123Arp/Electronic_System_Project/docs/images/02b_perfboard_with_mic.jpeg

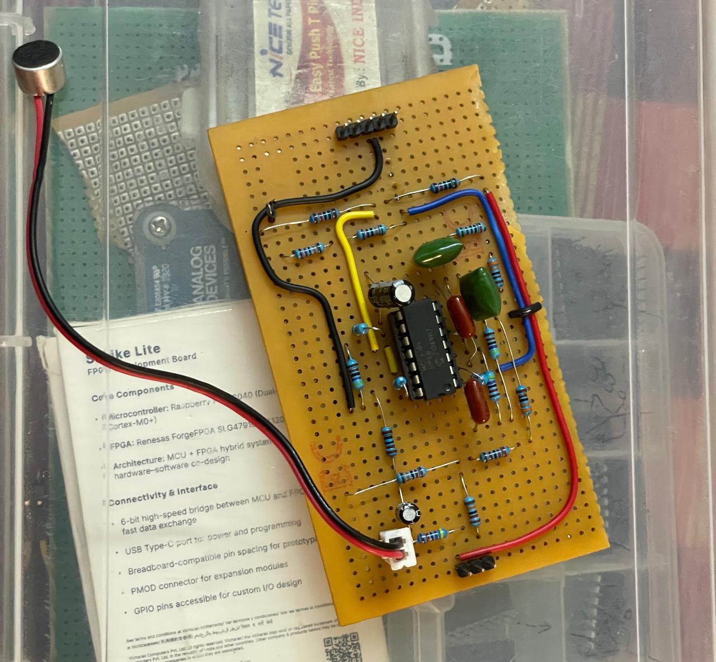
docs/images/02b_perfboard_with_mic.jpeg
