123Arp/Electronic_System_Project/docs/images/raw/WhatsApp Image 2026-10-01 at 6.32.37 PM (9).jpeg

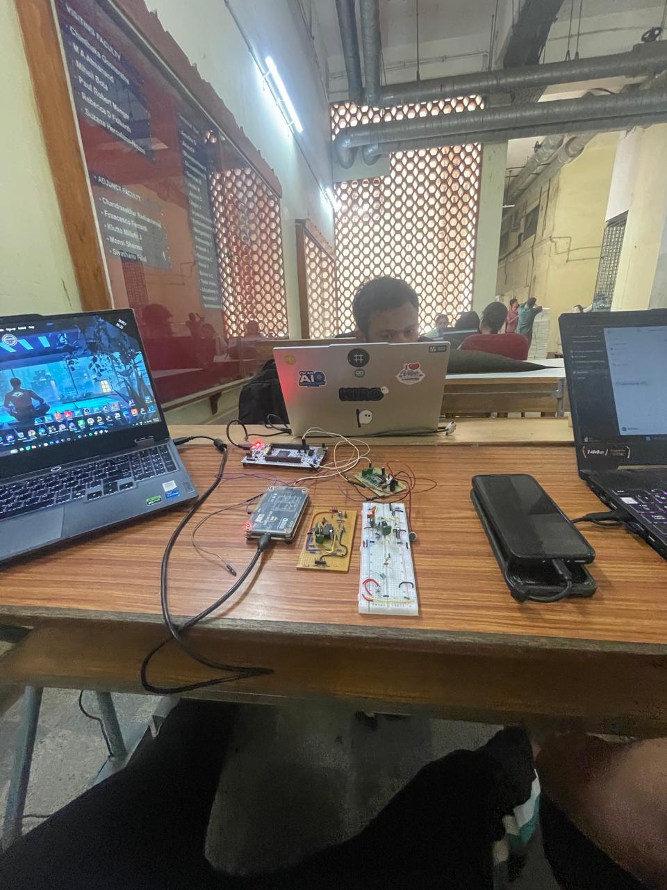
docs/images/raw/WhatsApp Image 2026-10-01 at 6.32.37 PM (9).jpeg
