123Arp/Electronic_System_Project/docs/Project_Report.pdf

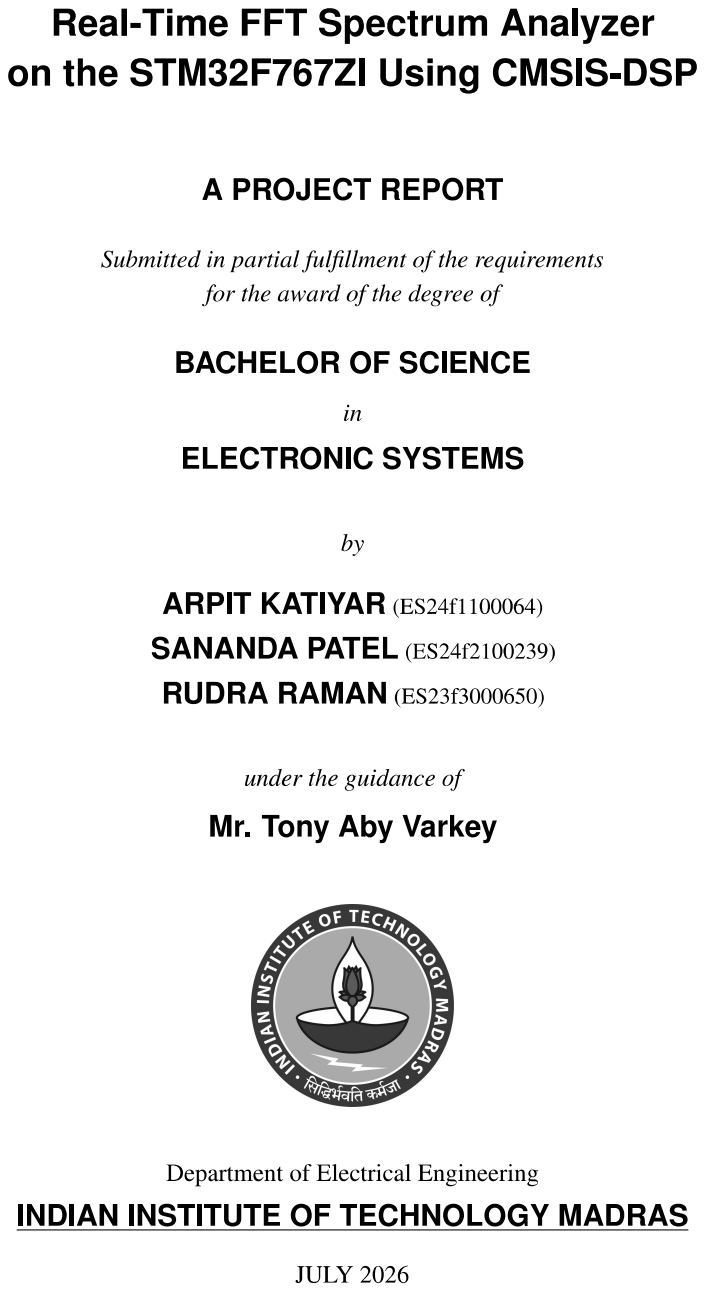
[picture p13: page 1]

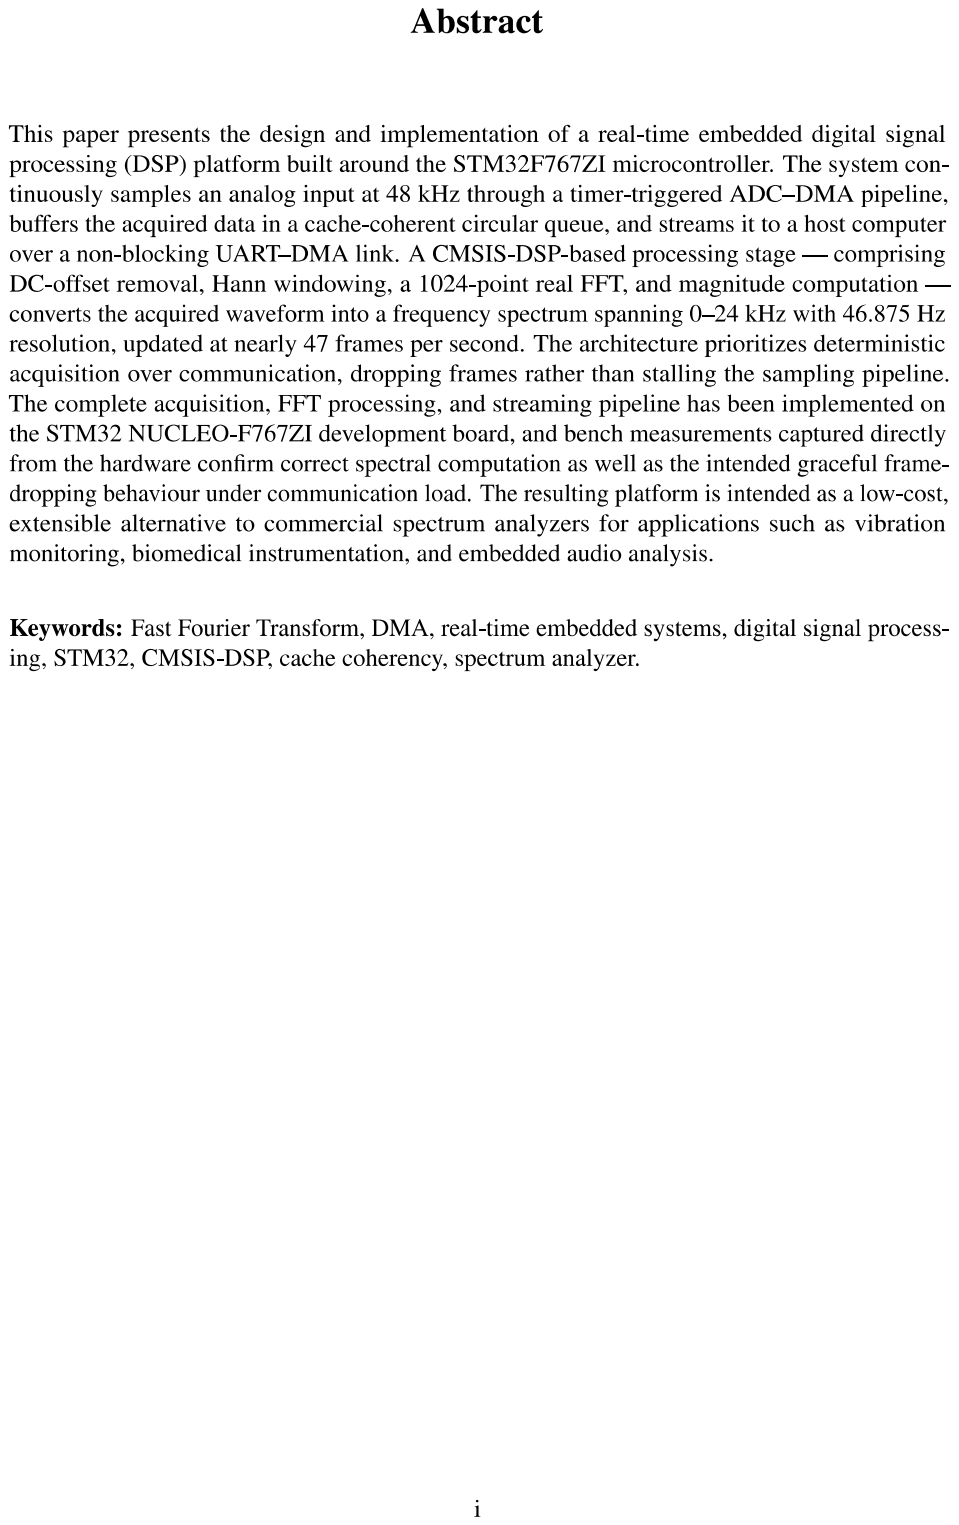
[picture p14: page 2]

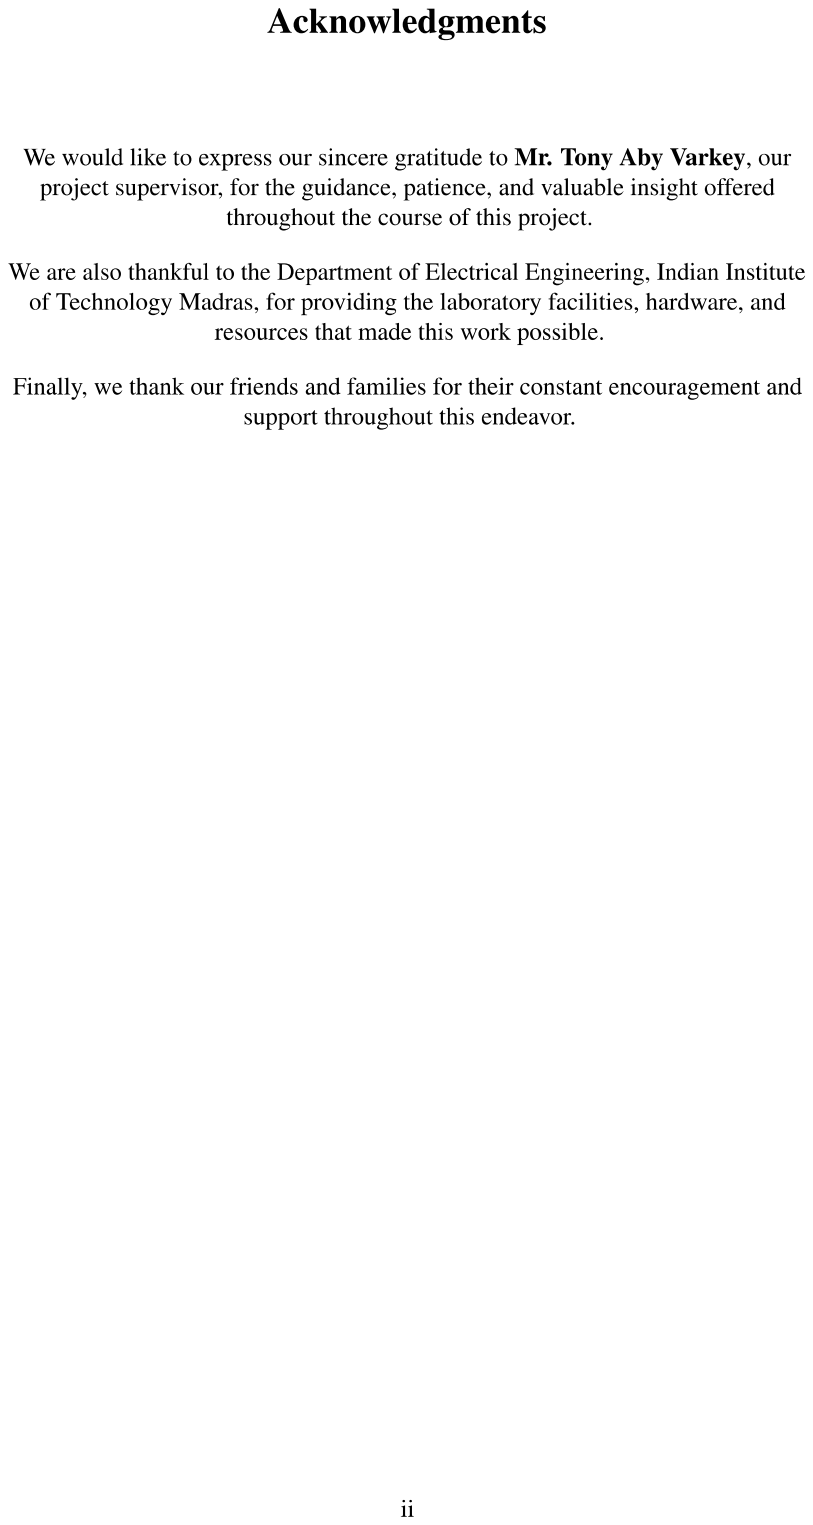
[picture p15: page 3]

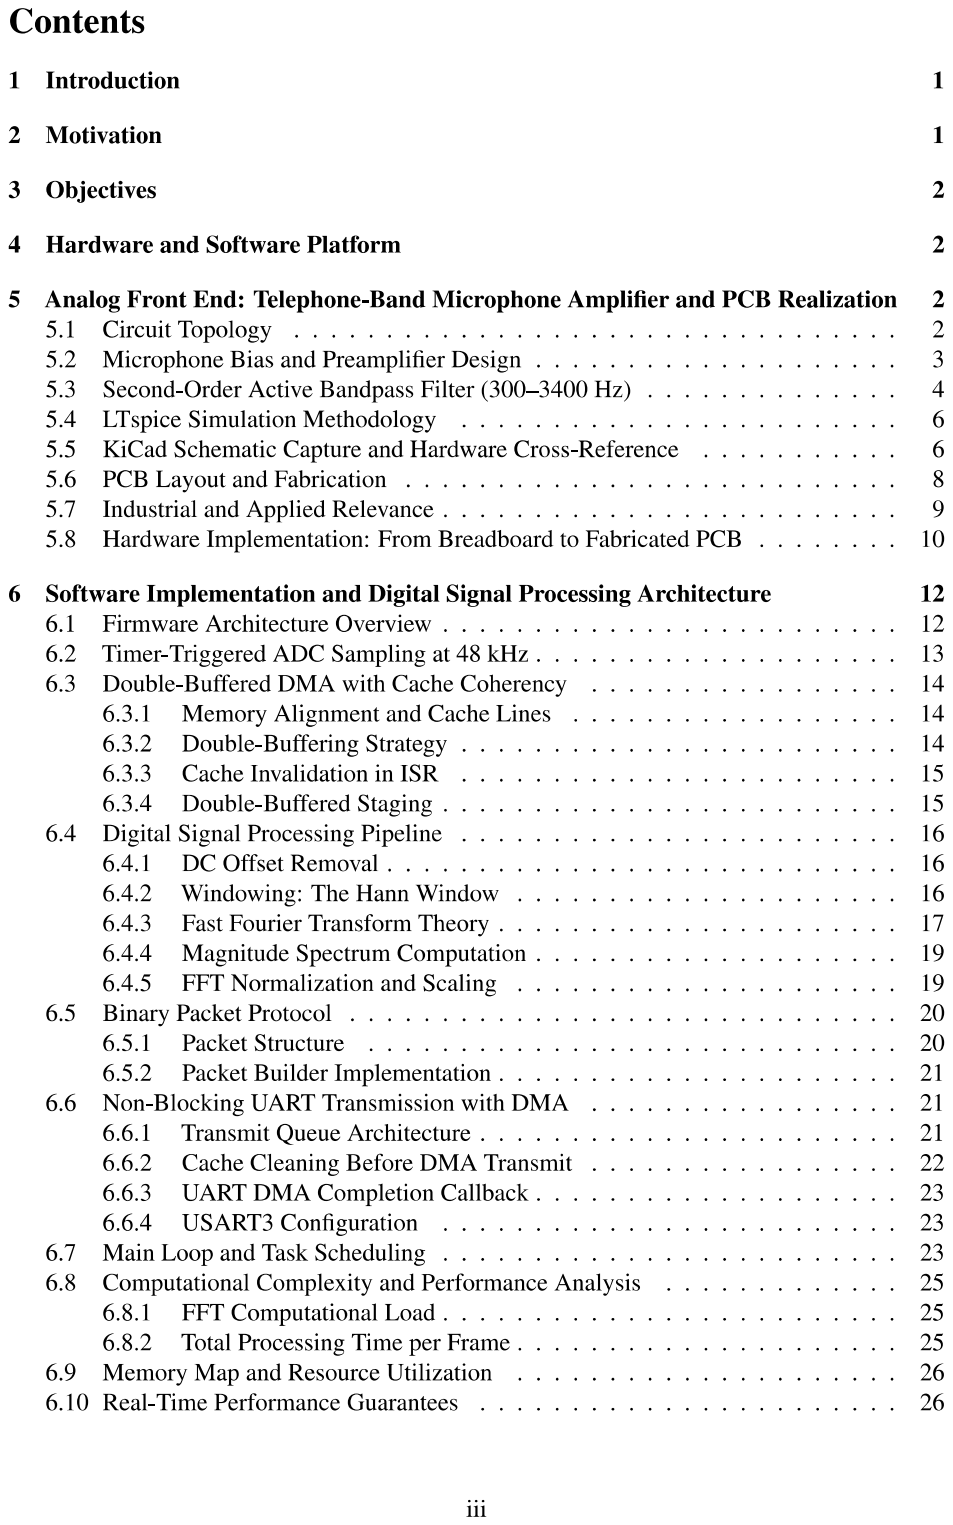
[picture p16: page 4]

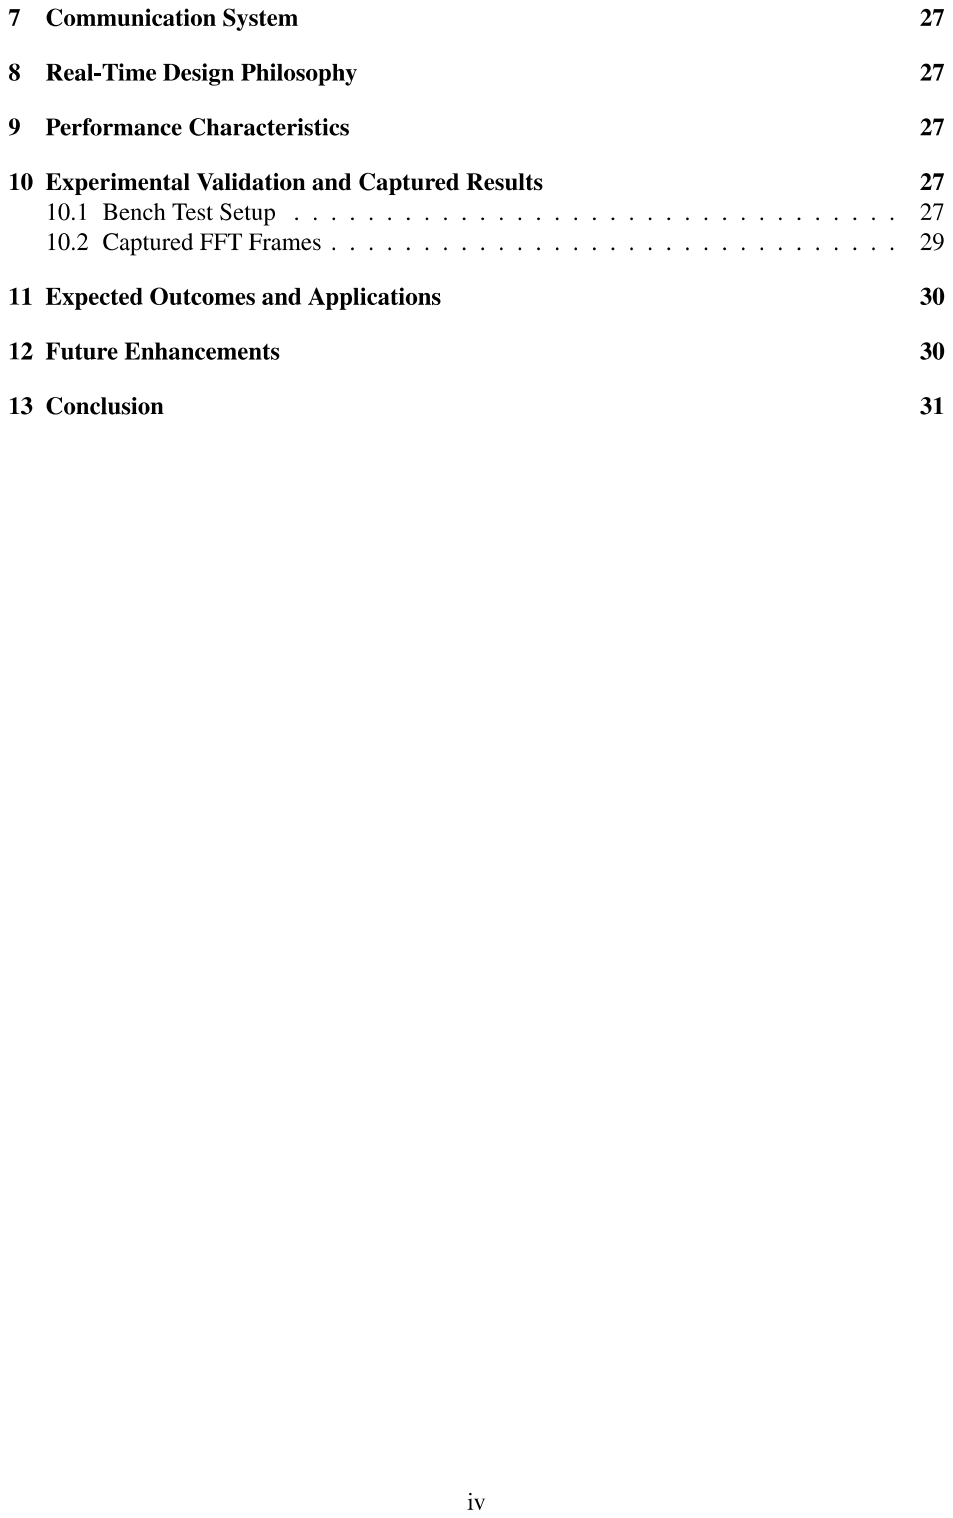
[picture p17: page 5]

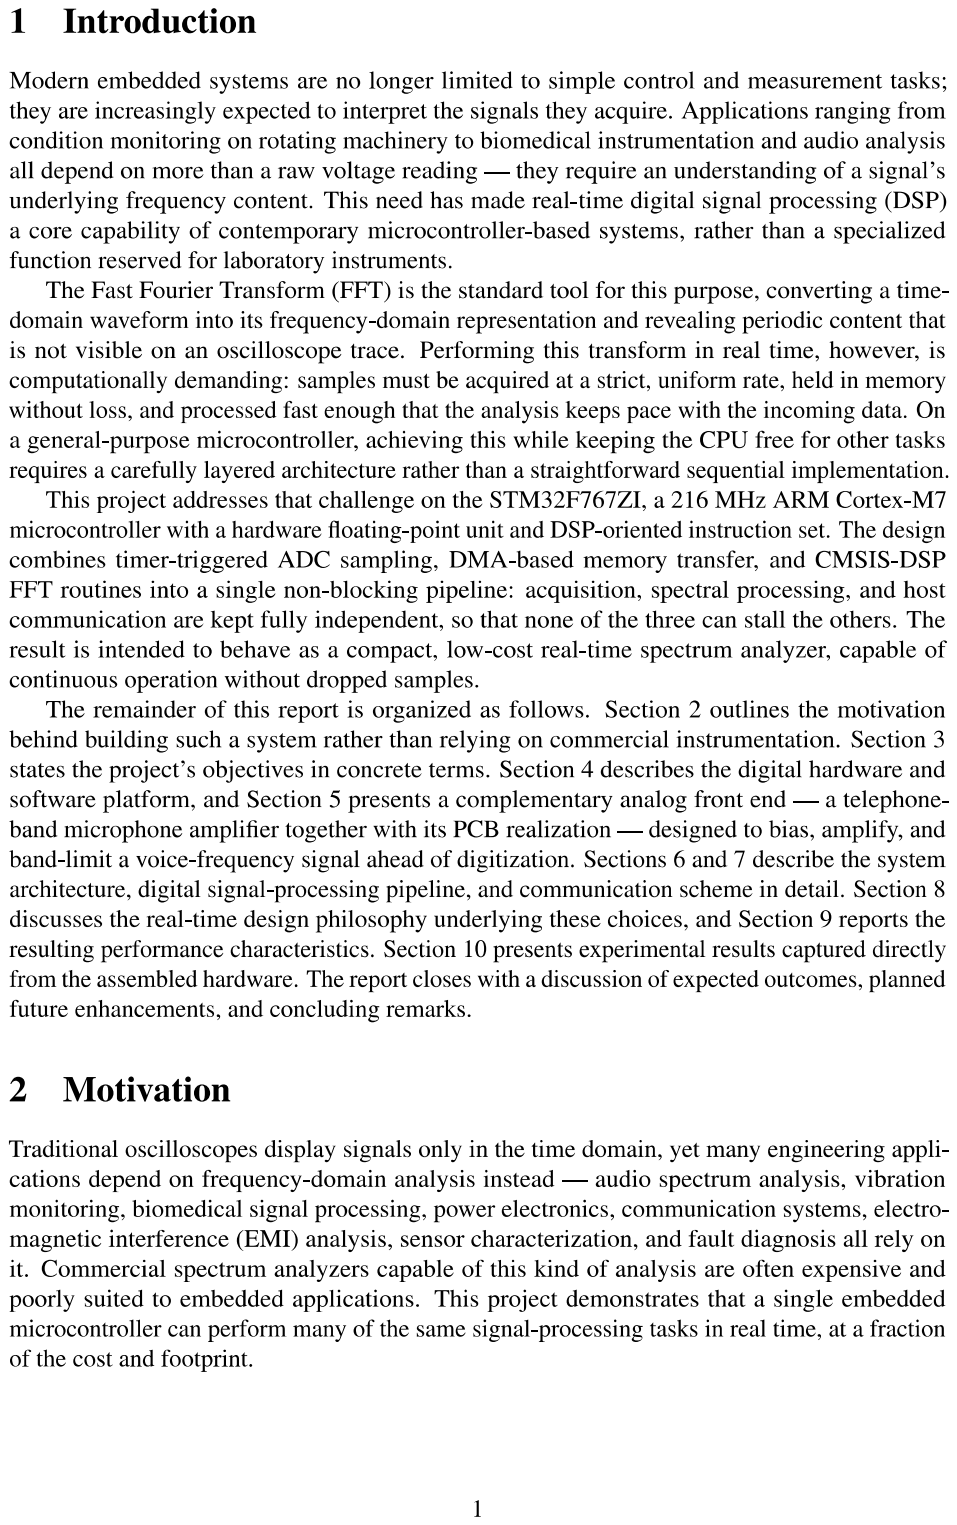
[picture p18: page 6]

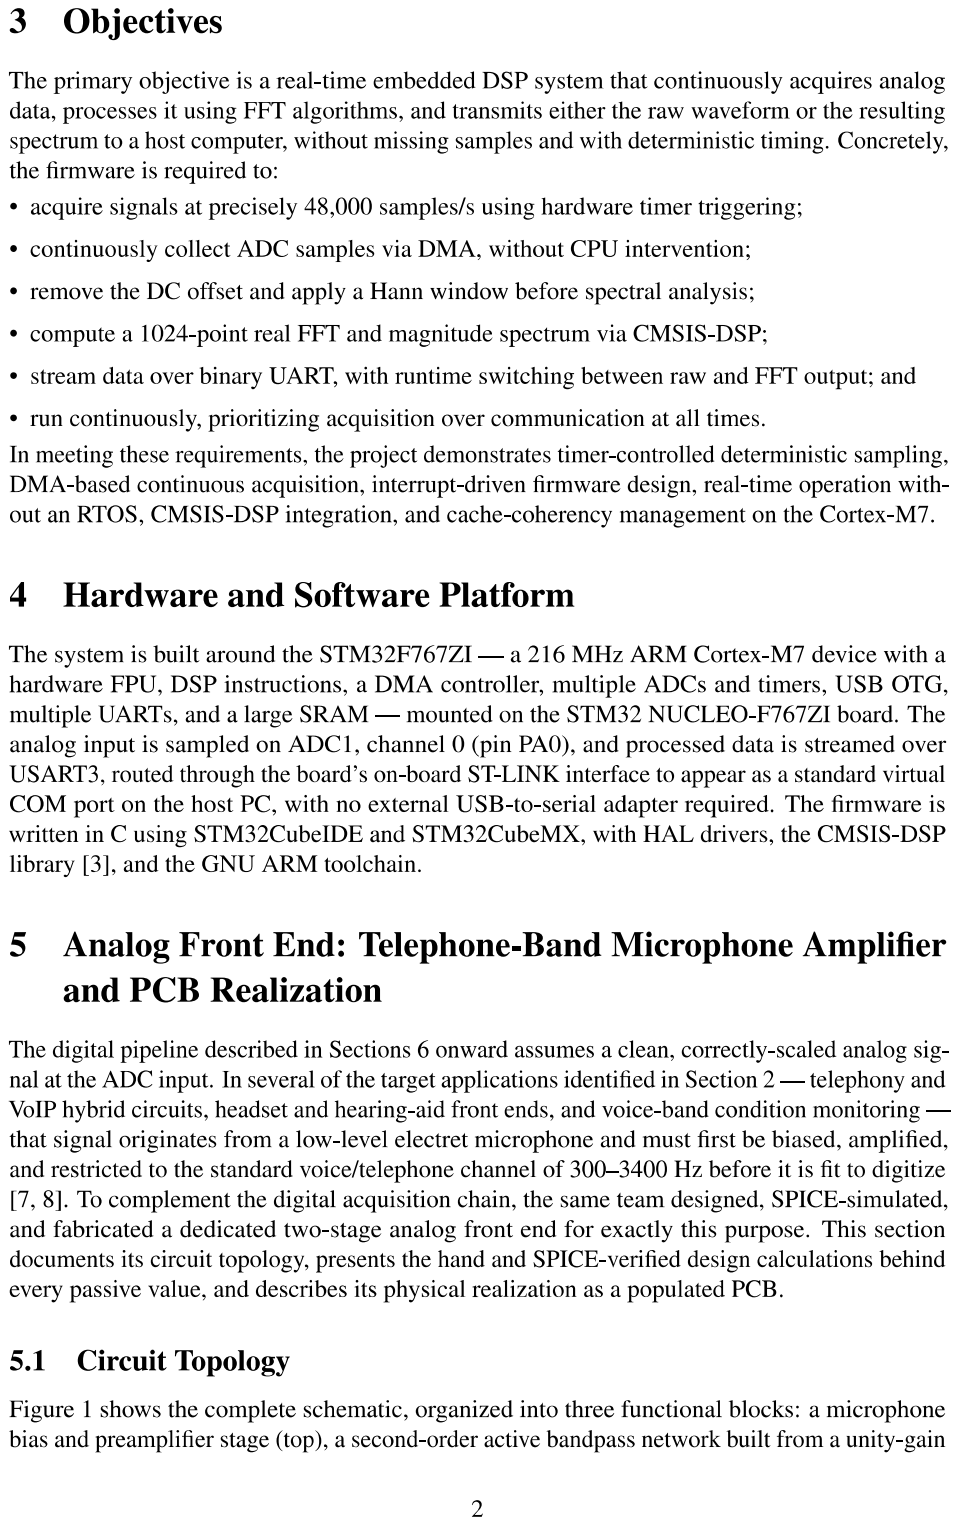
[picture p19: page 7]

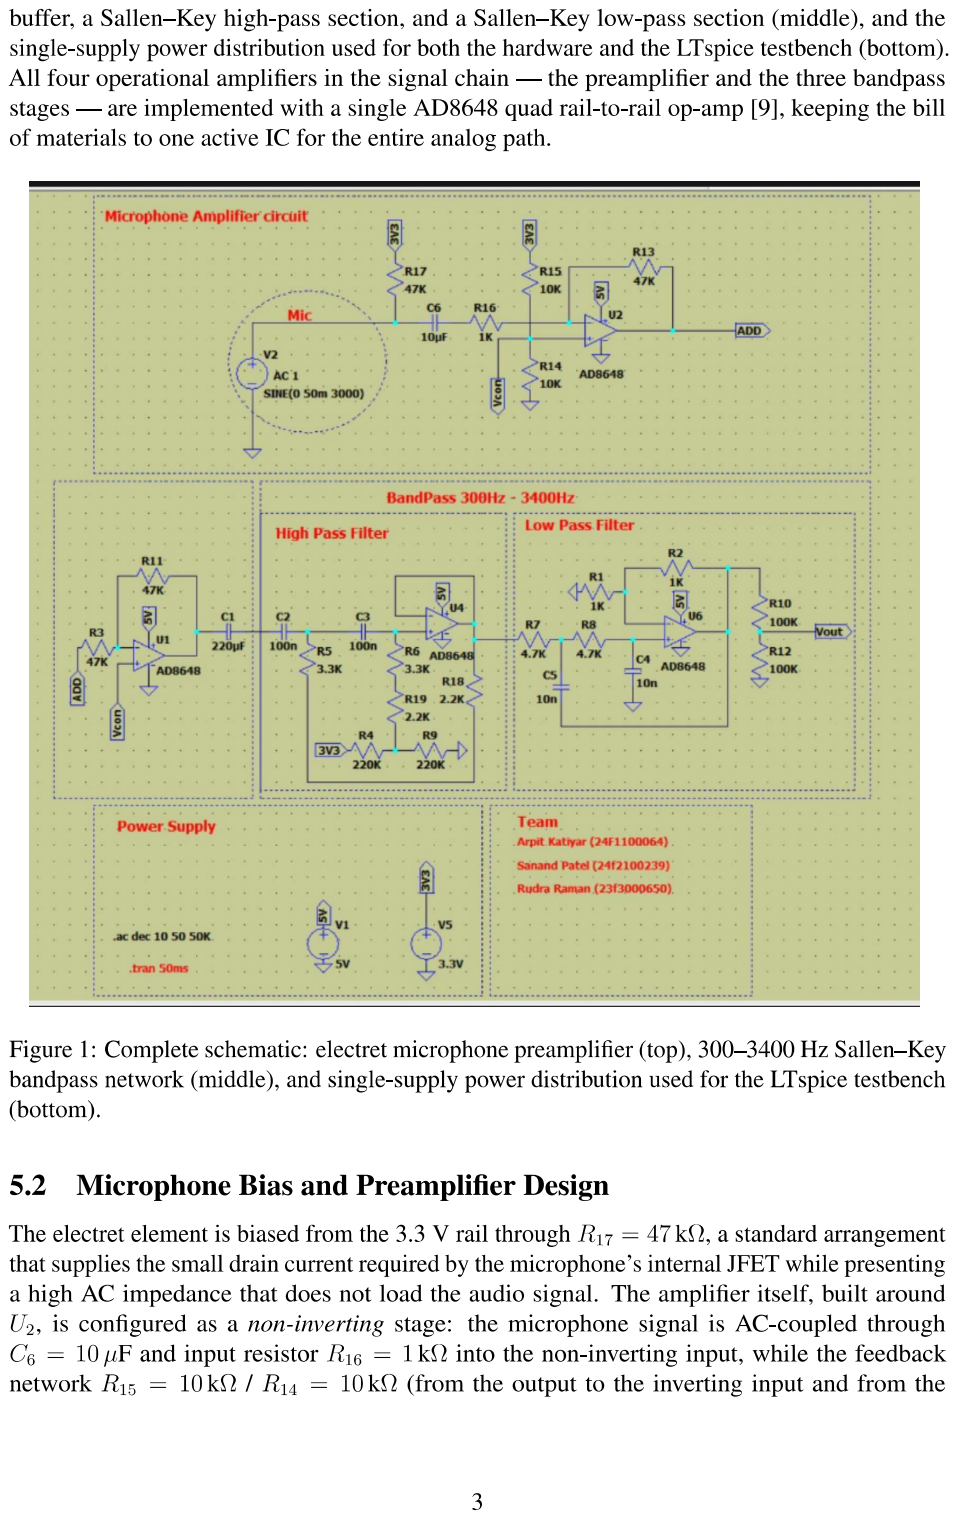
[picture p20: page 8]

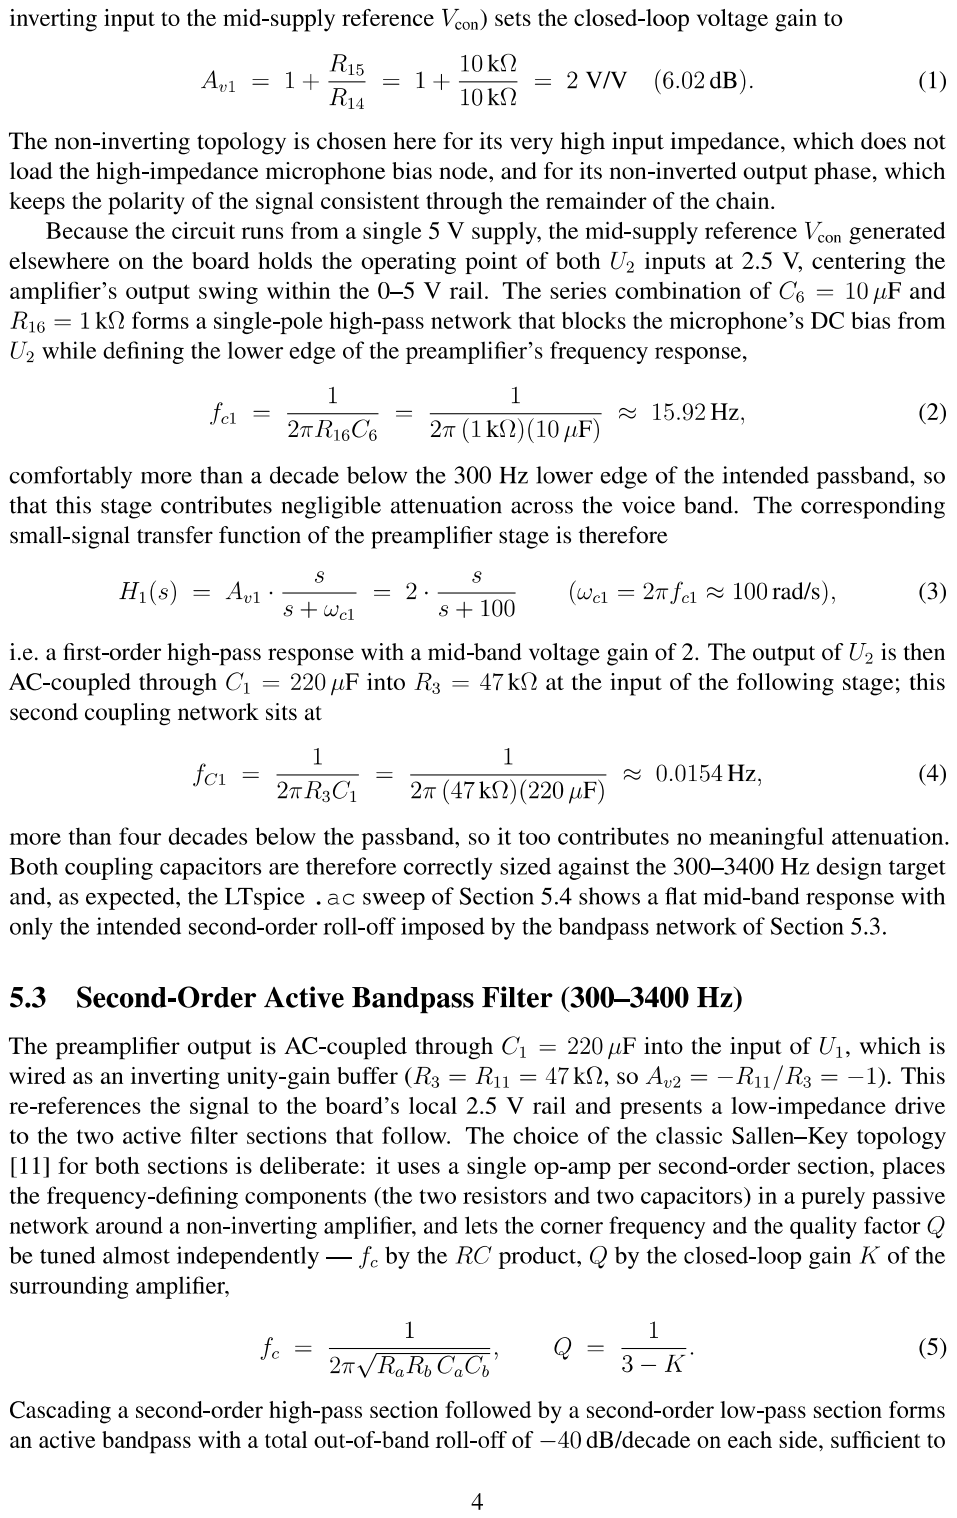
[picture p21: page 9]

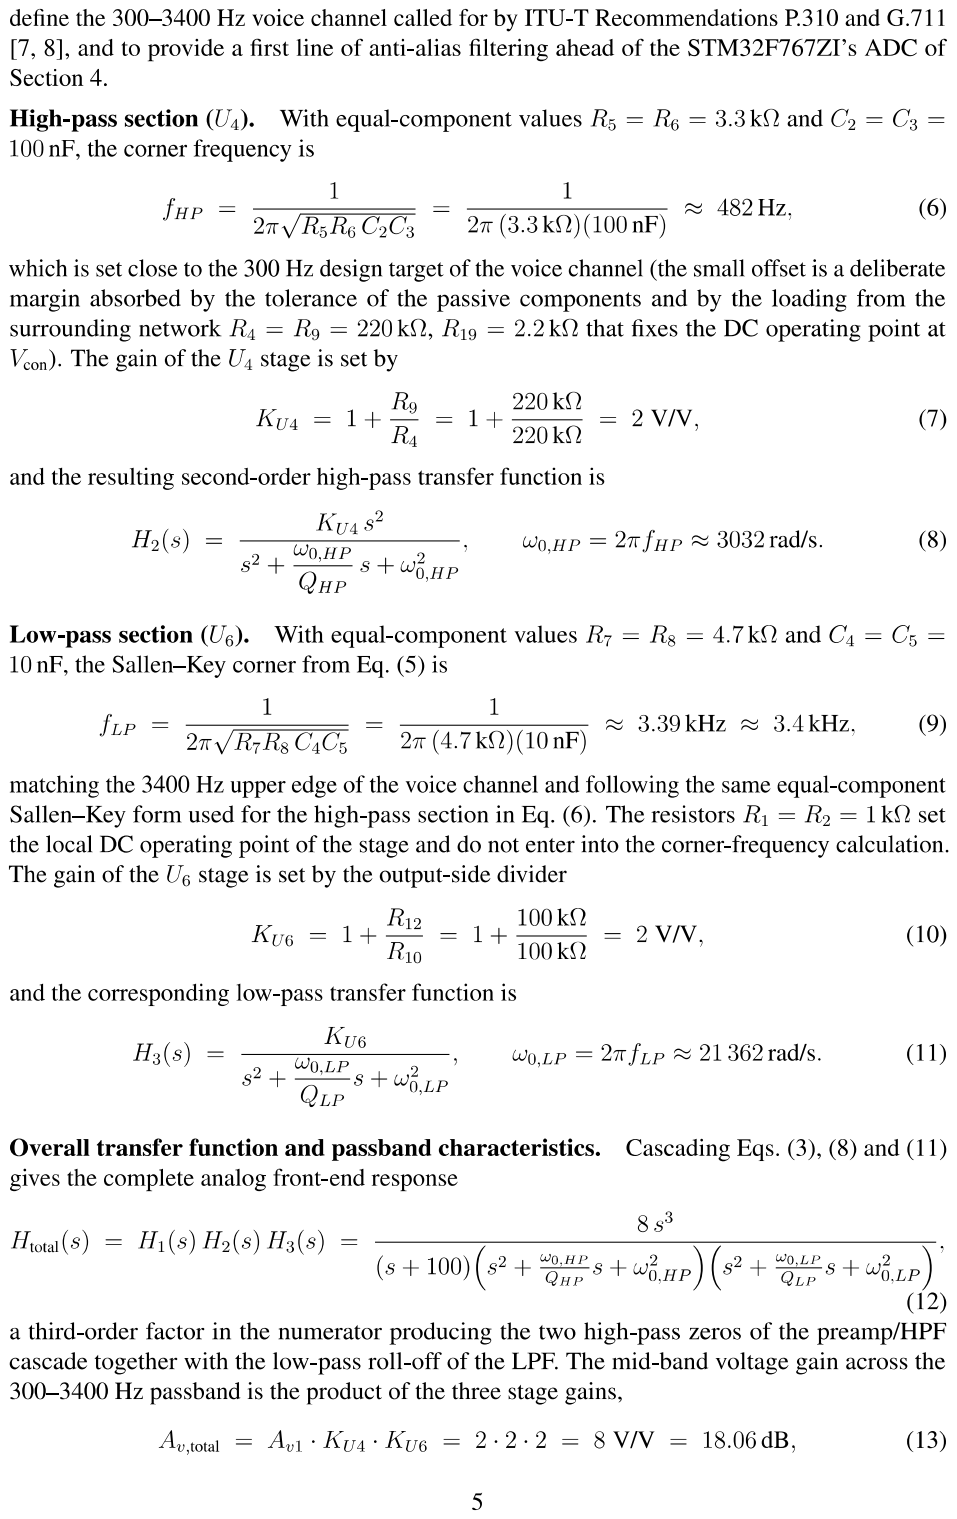
[picture p22: page 10]

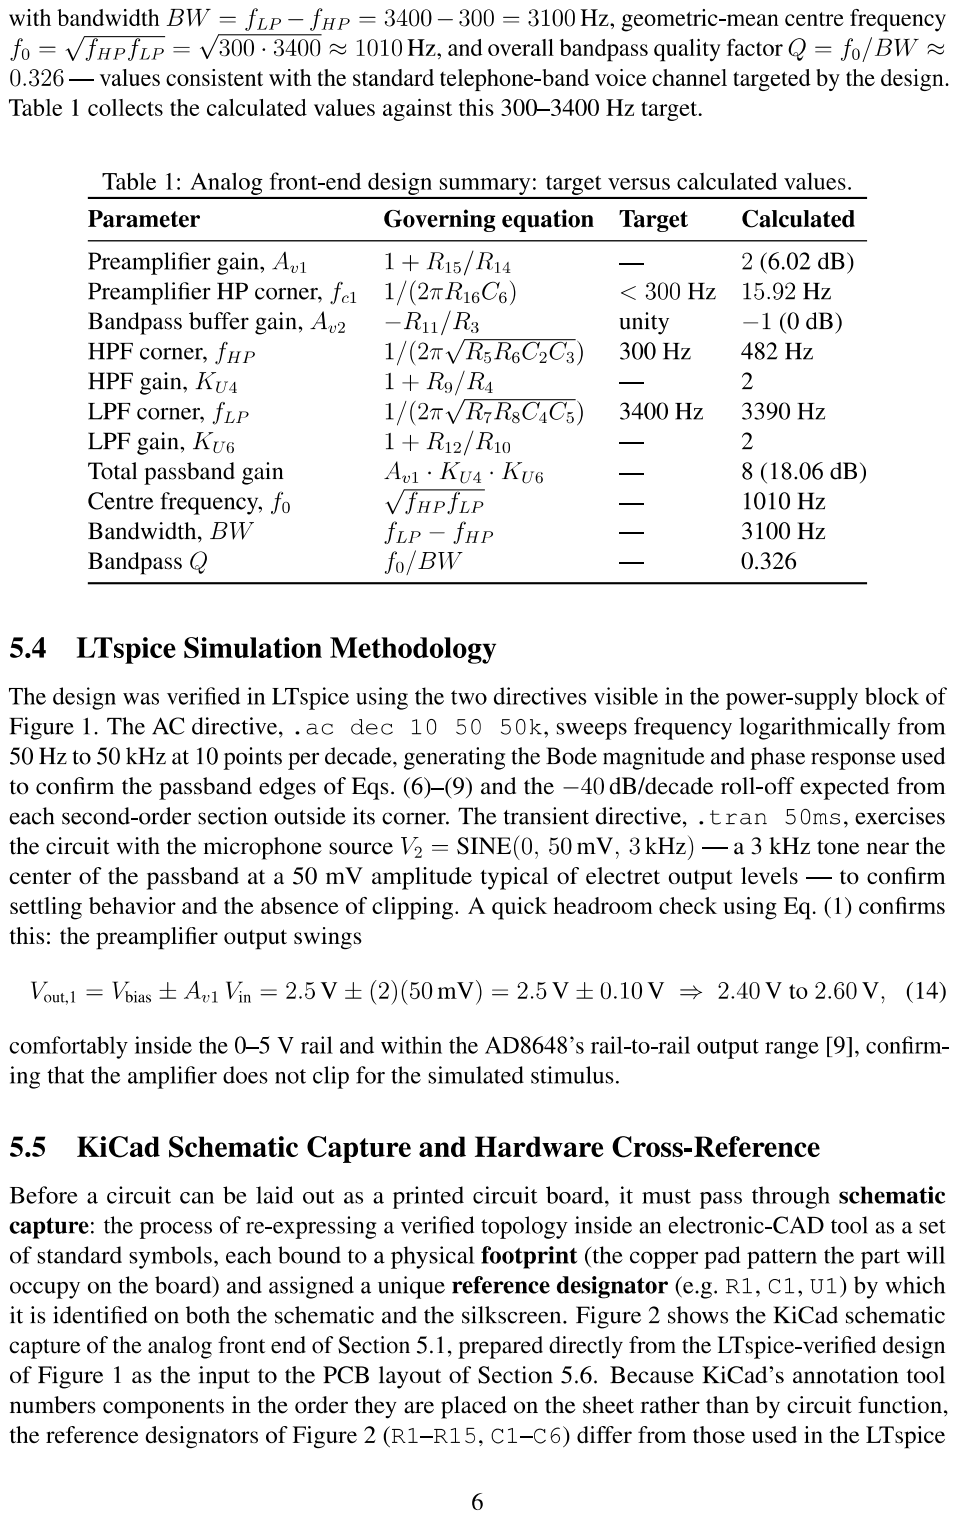
[picture p23: page 11]

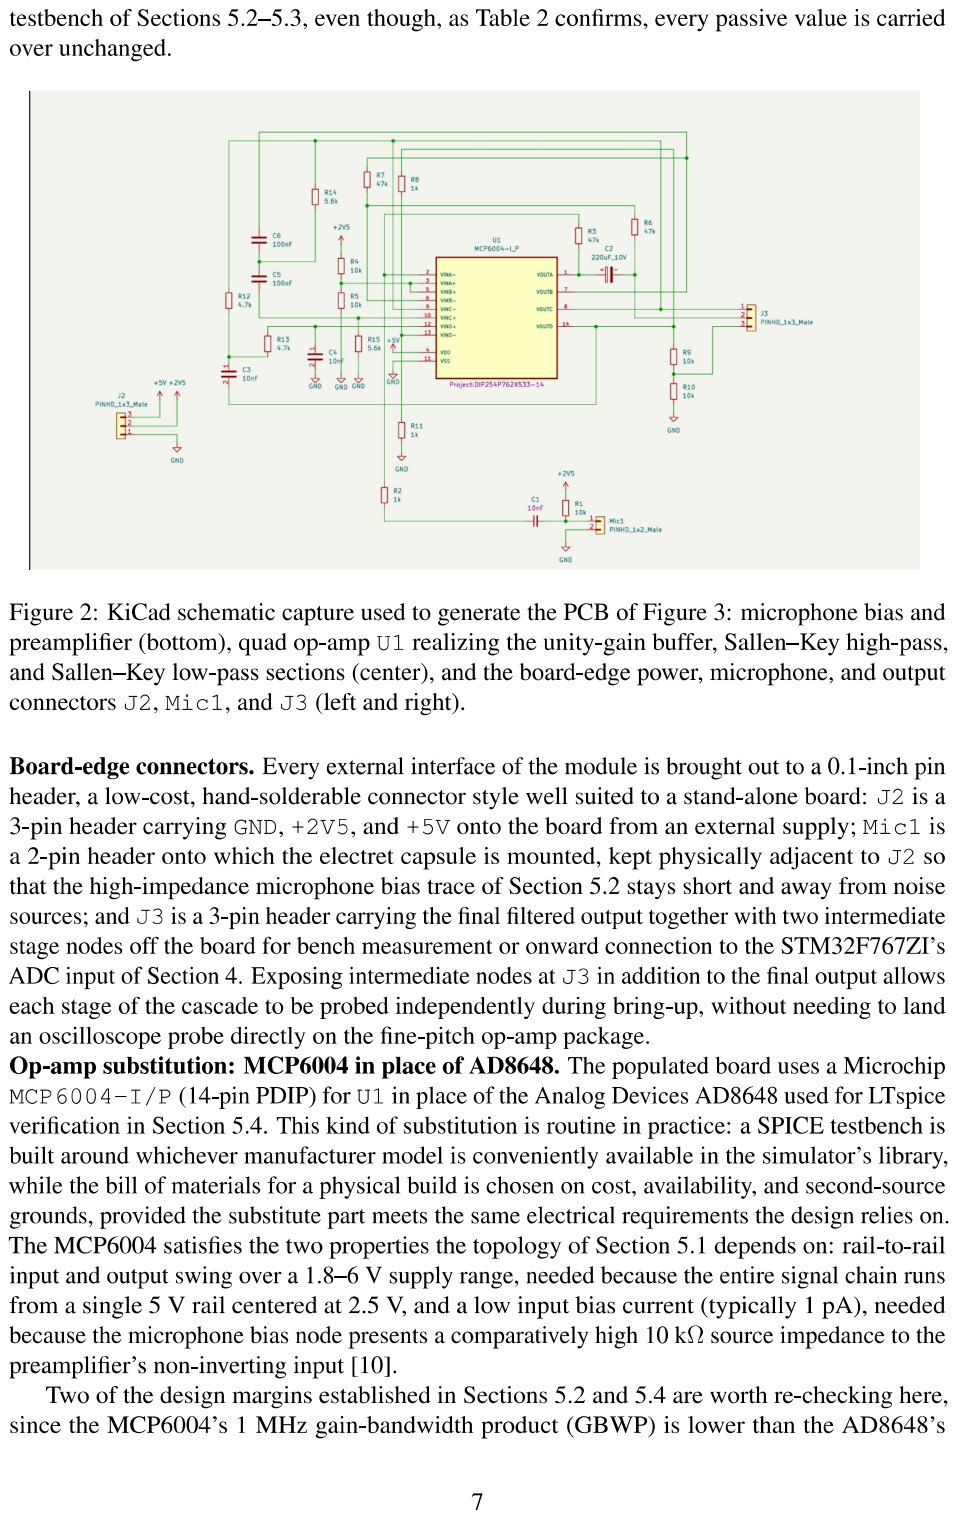
[picture p24: page 12]

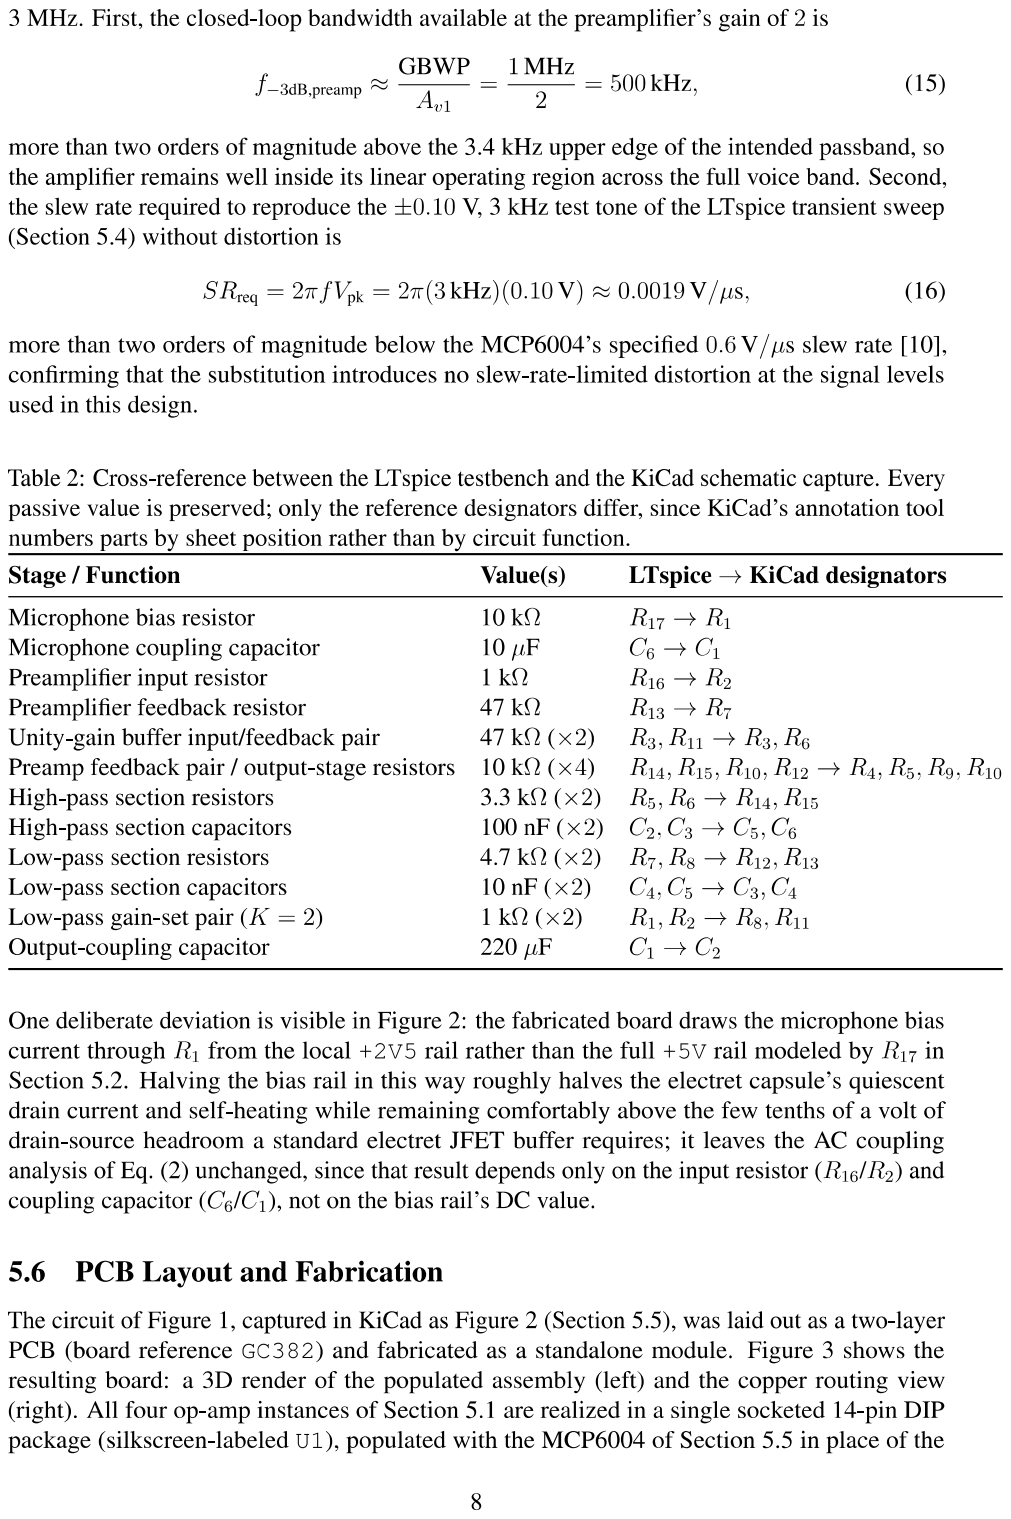
[picture p25: page 13]

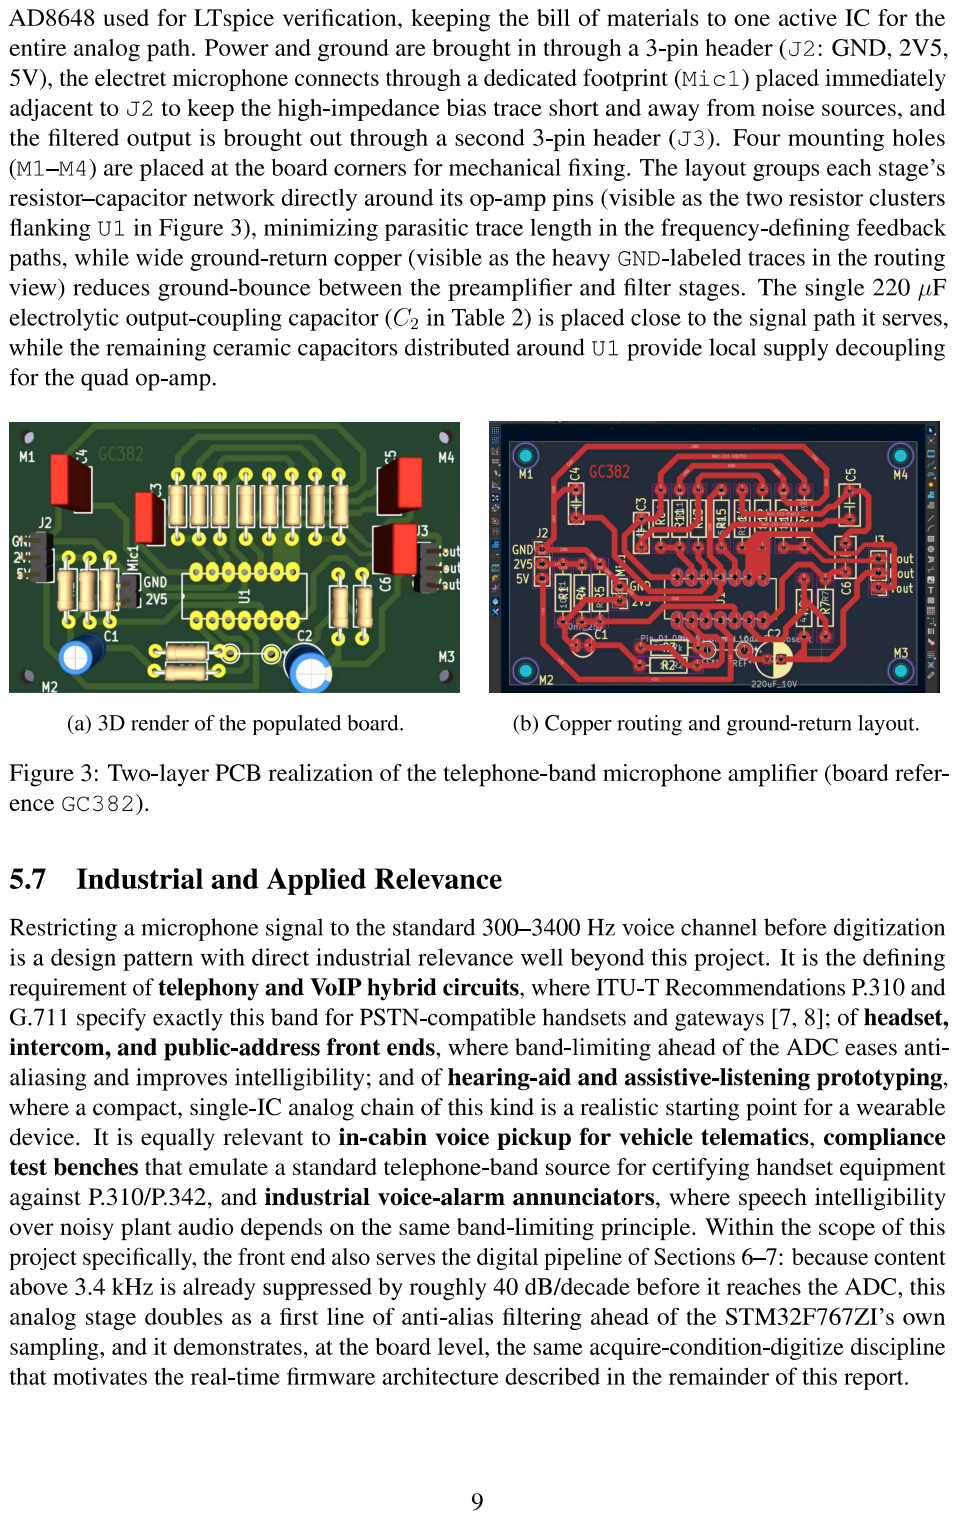
[picture p26: page 14]

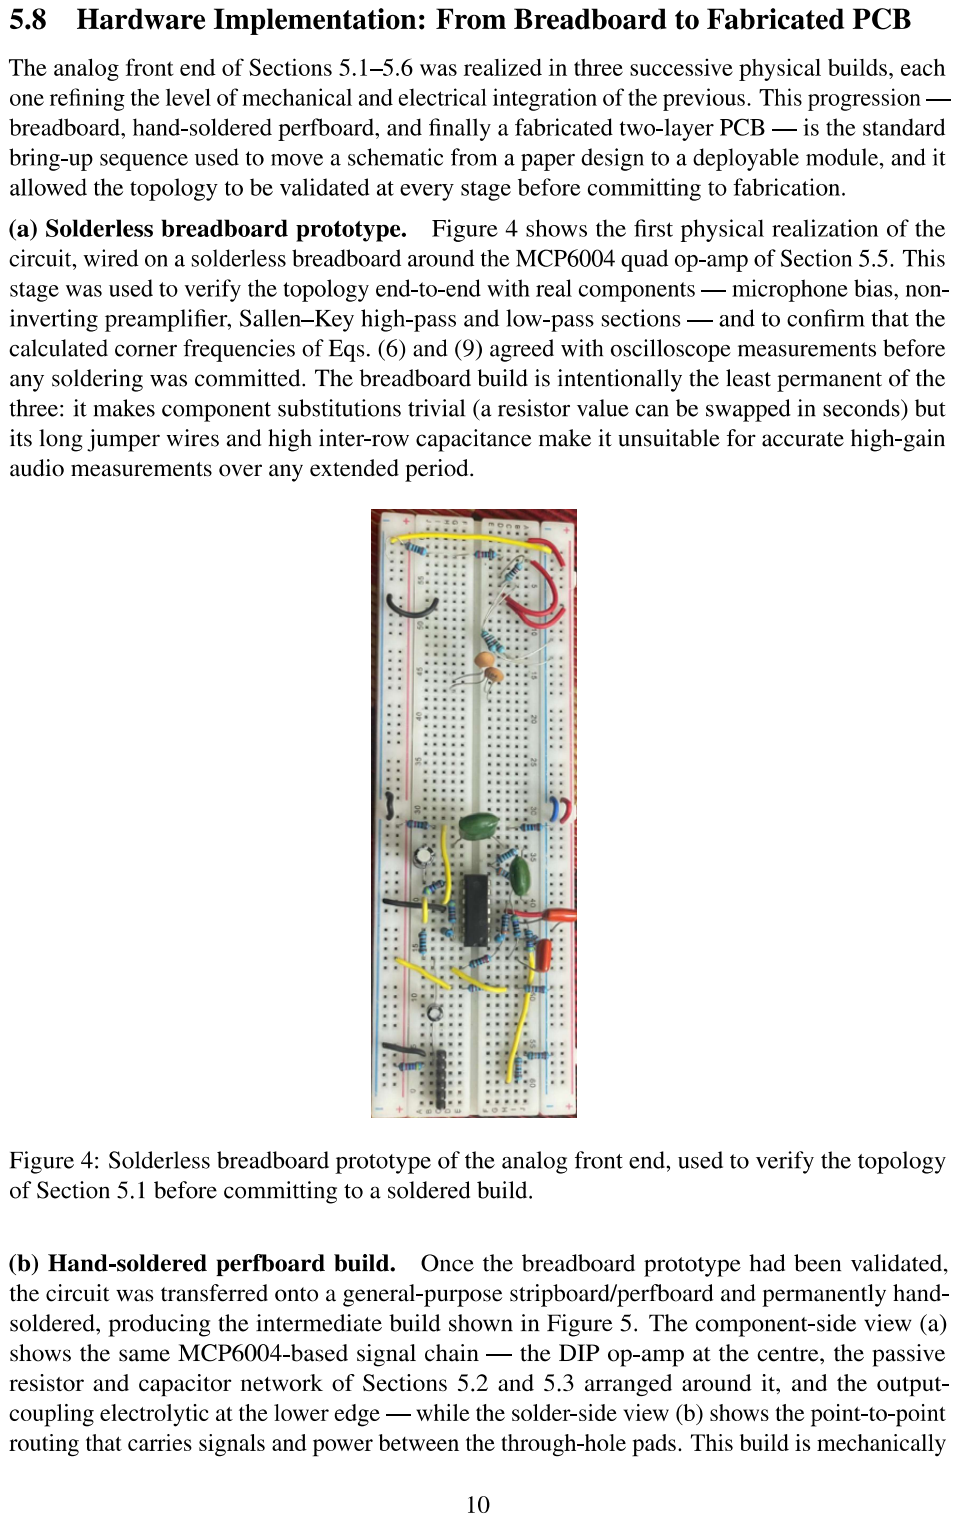
[picture p27: page 15]

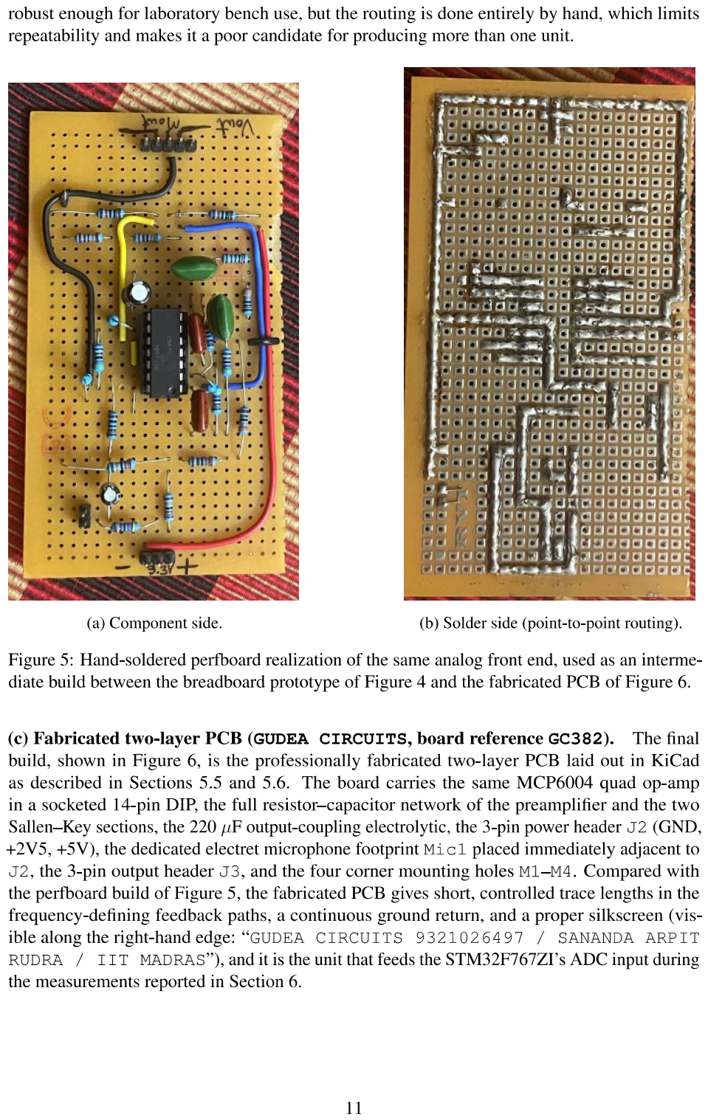
[picture p28: page 16]

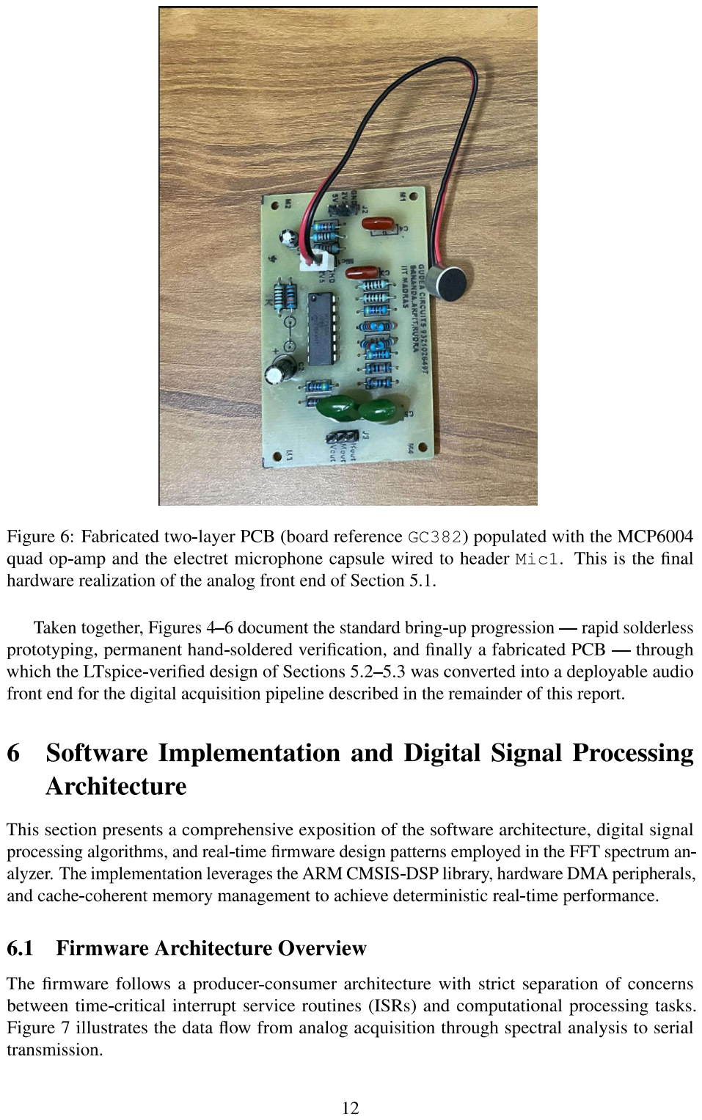
[picture p29: page 17]

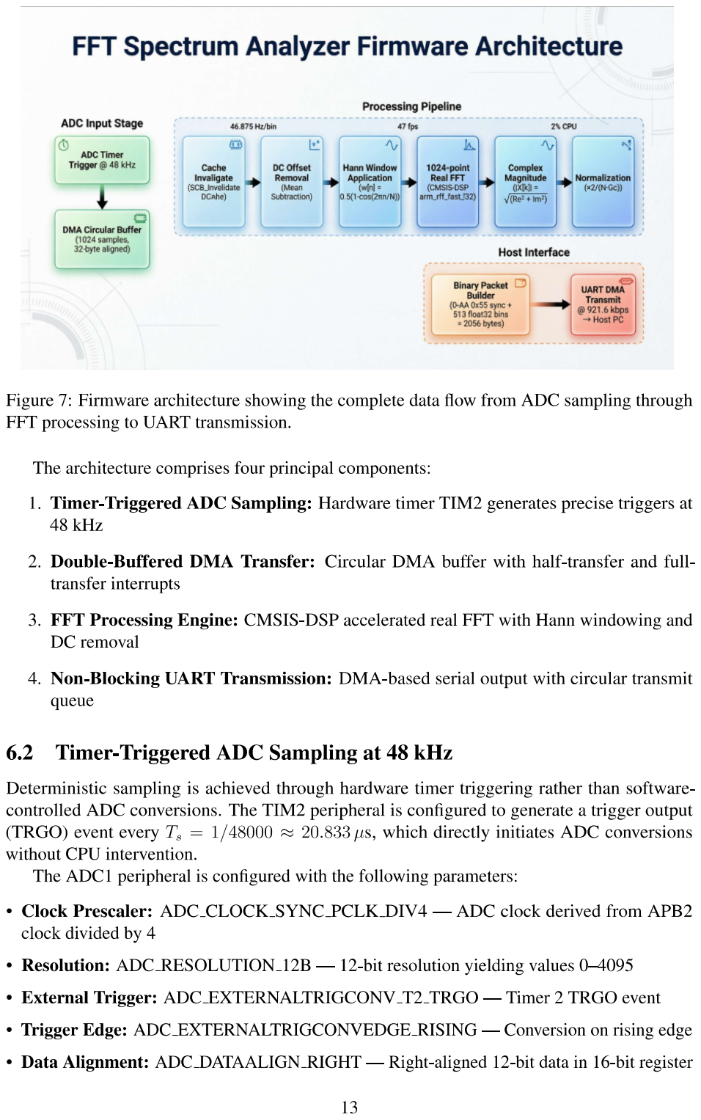
[picture p30: page 18]

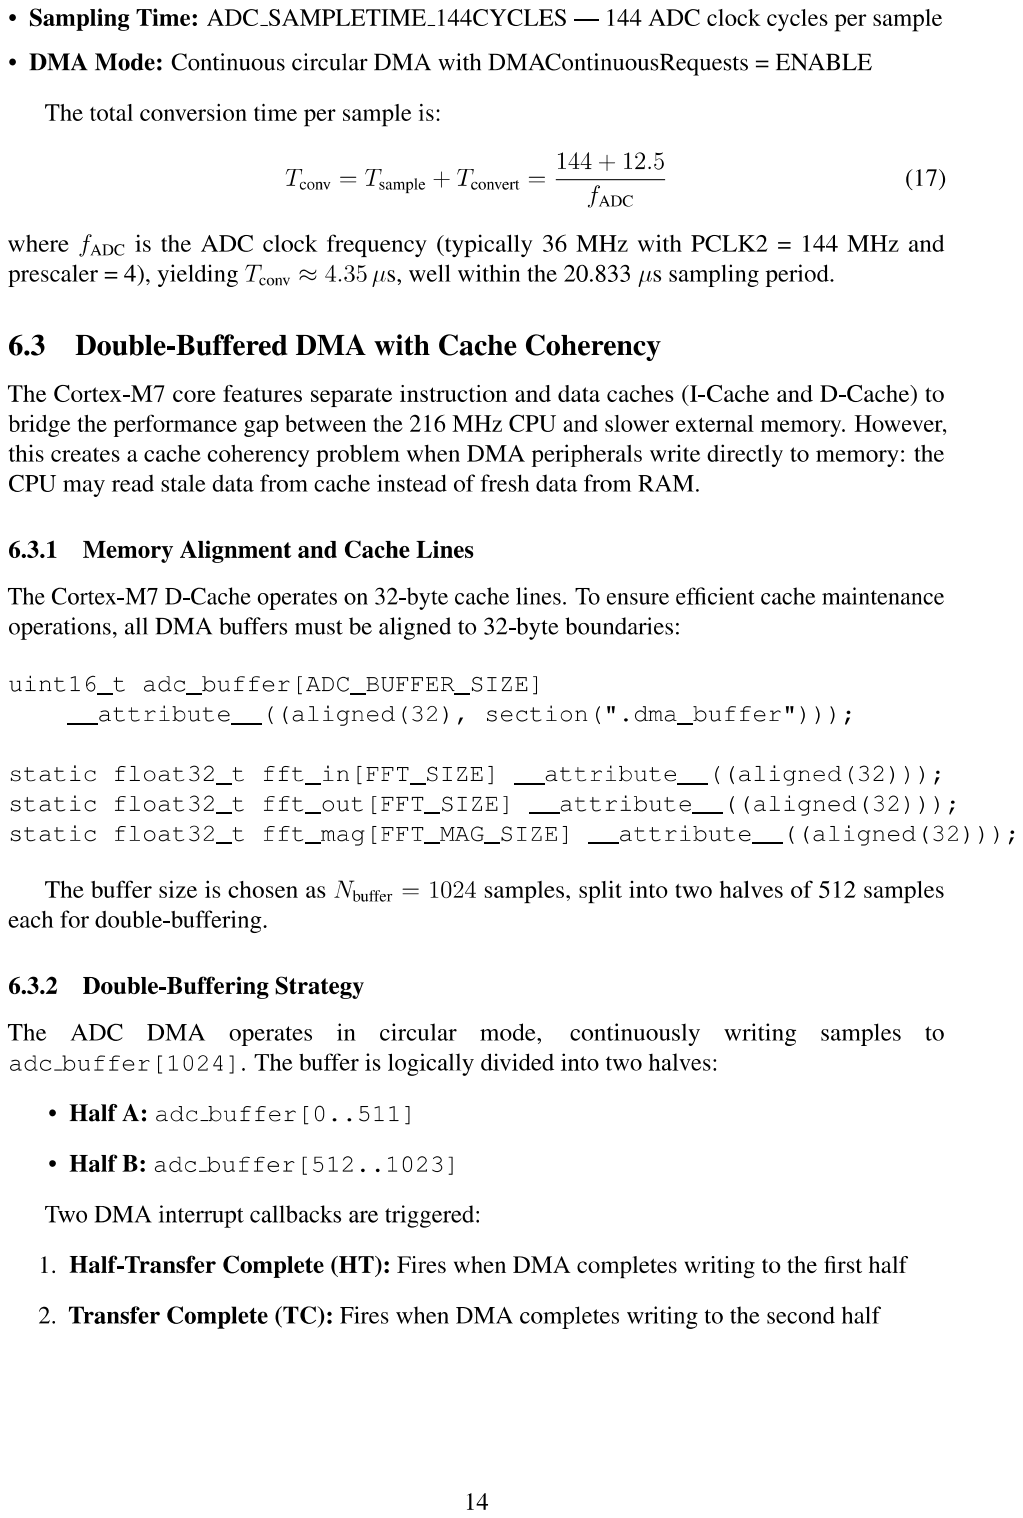
[picture p31: page 19]

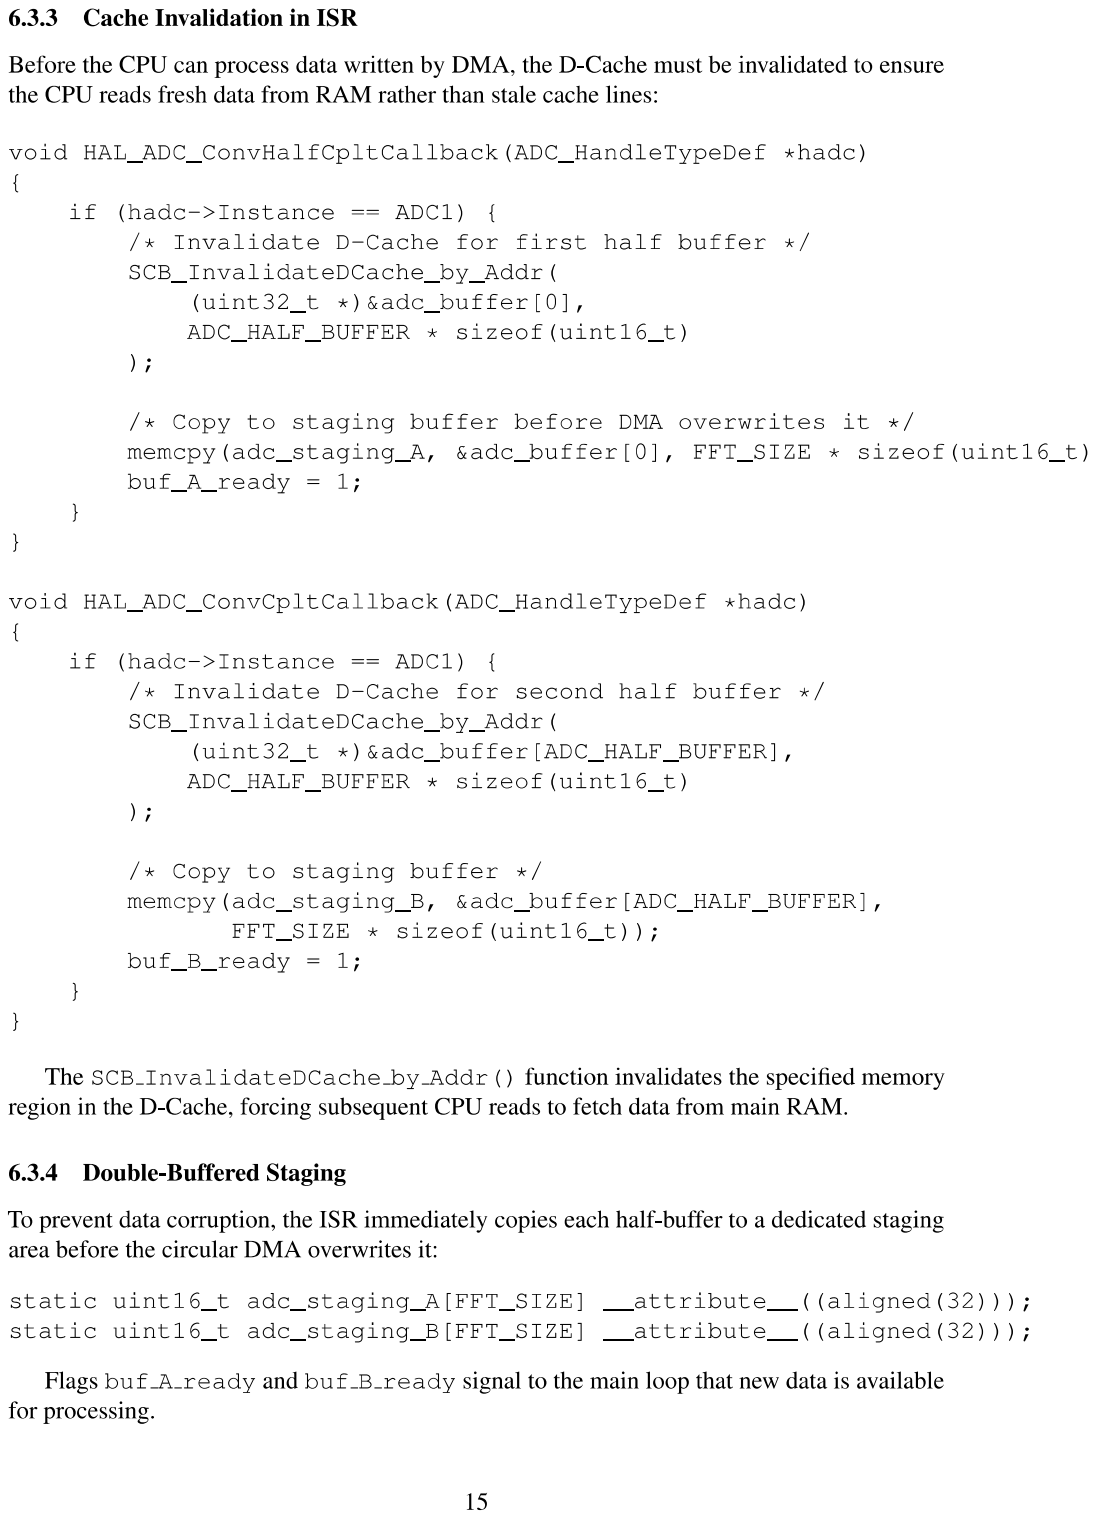
[picture p32: page 20]

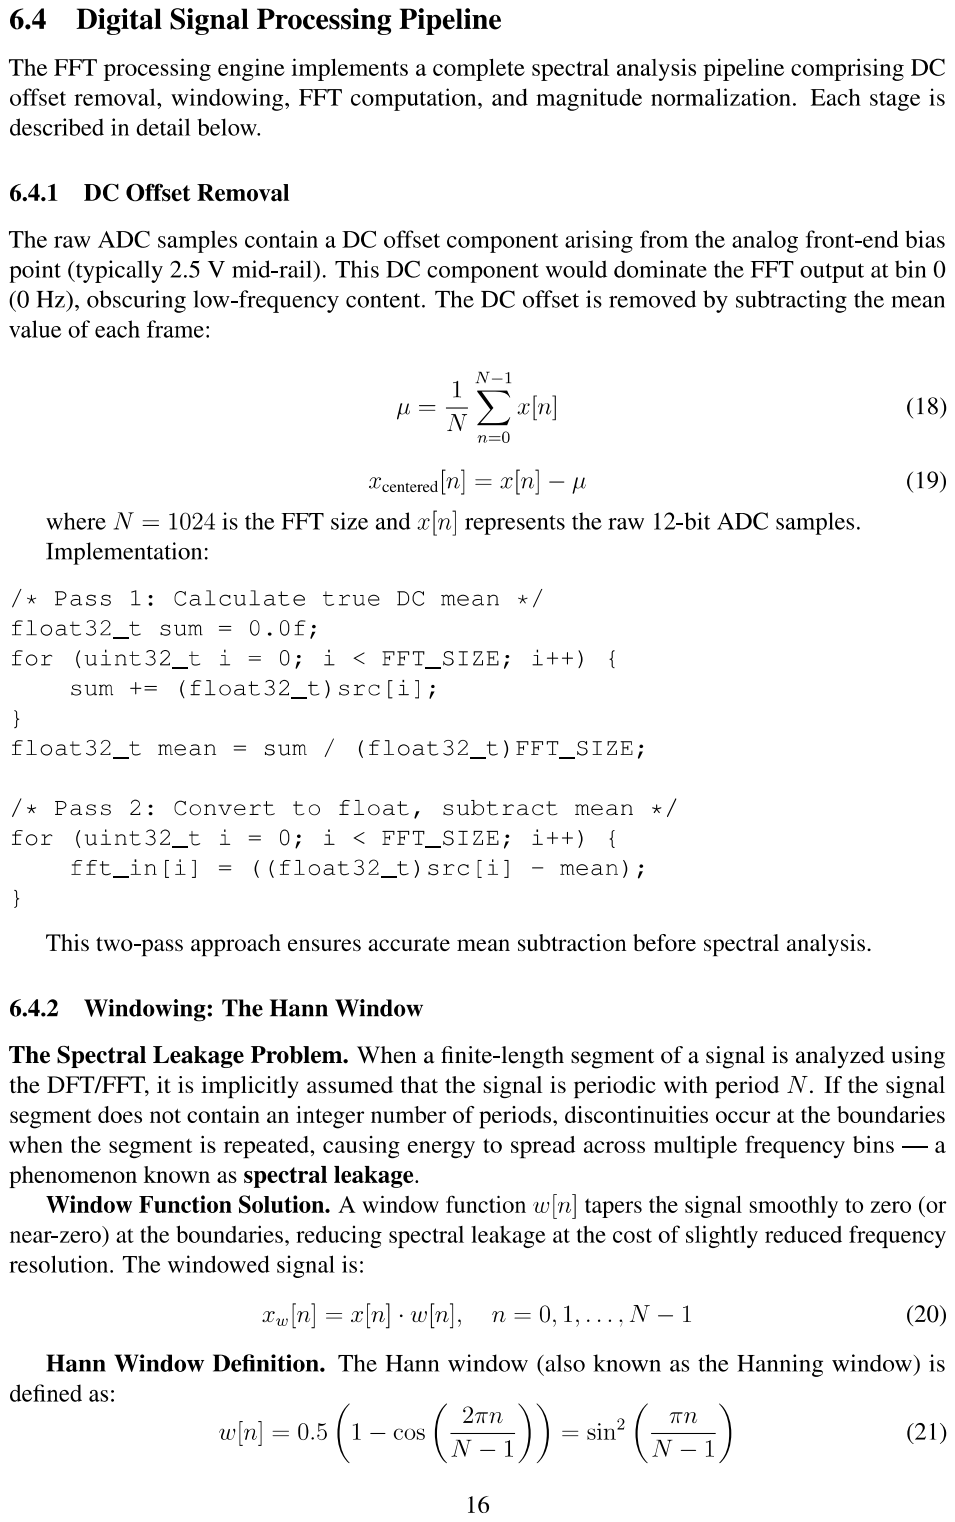
[picture p33: page 21]

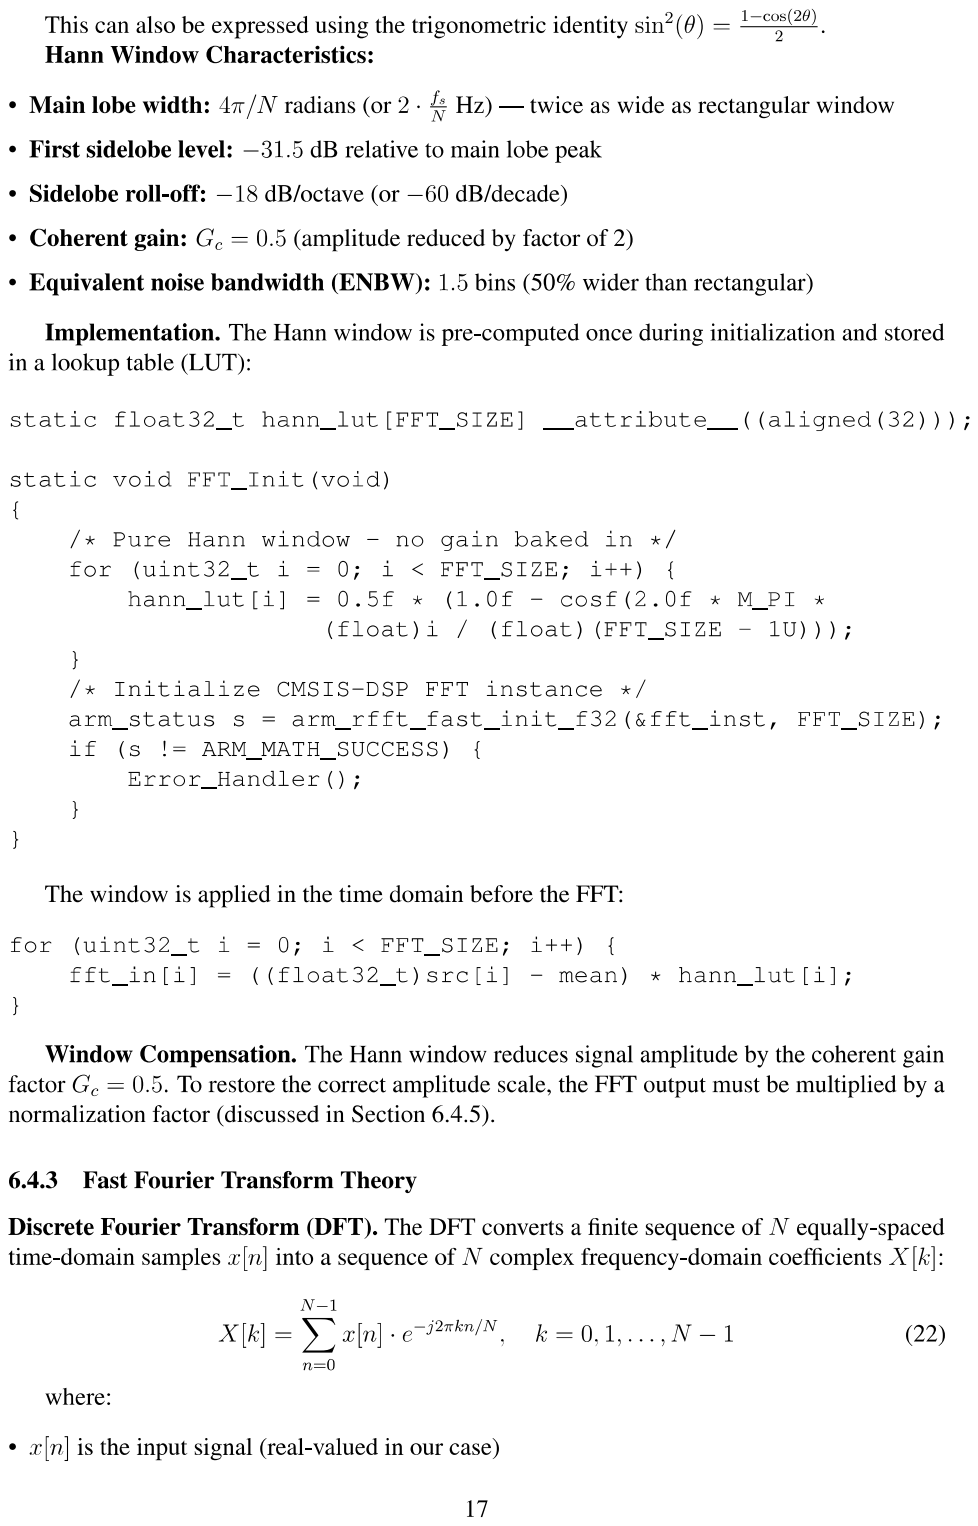
[picture p34: page 22]

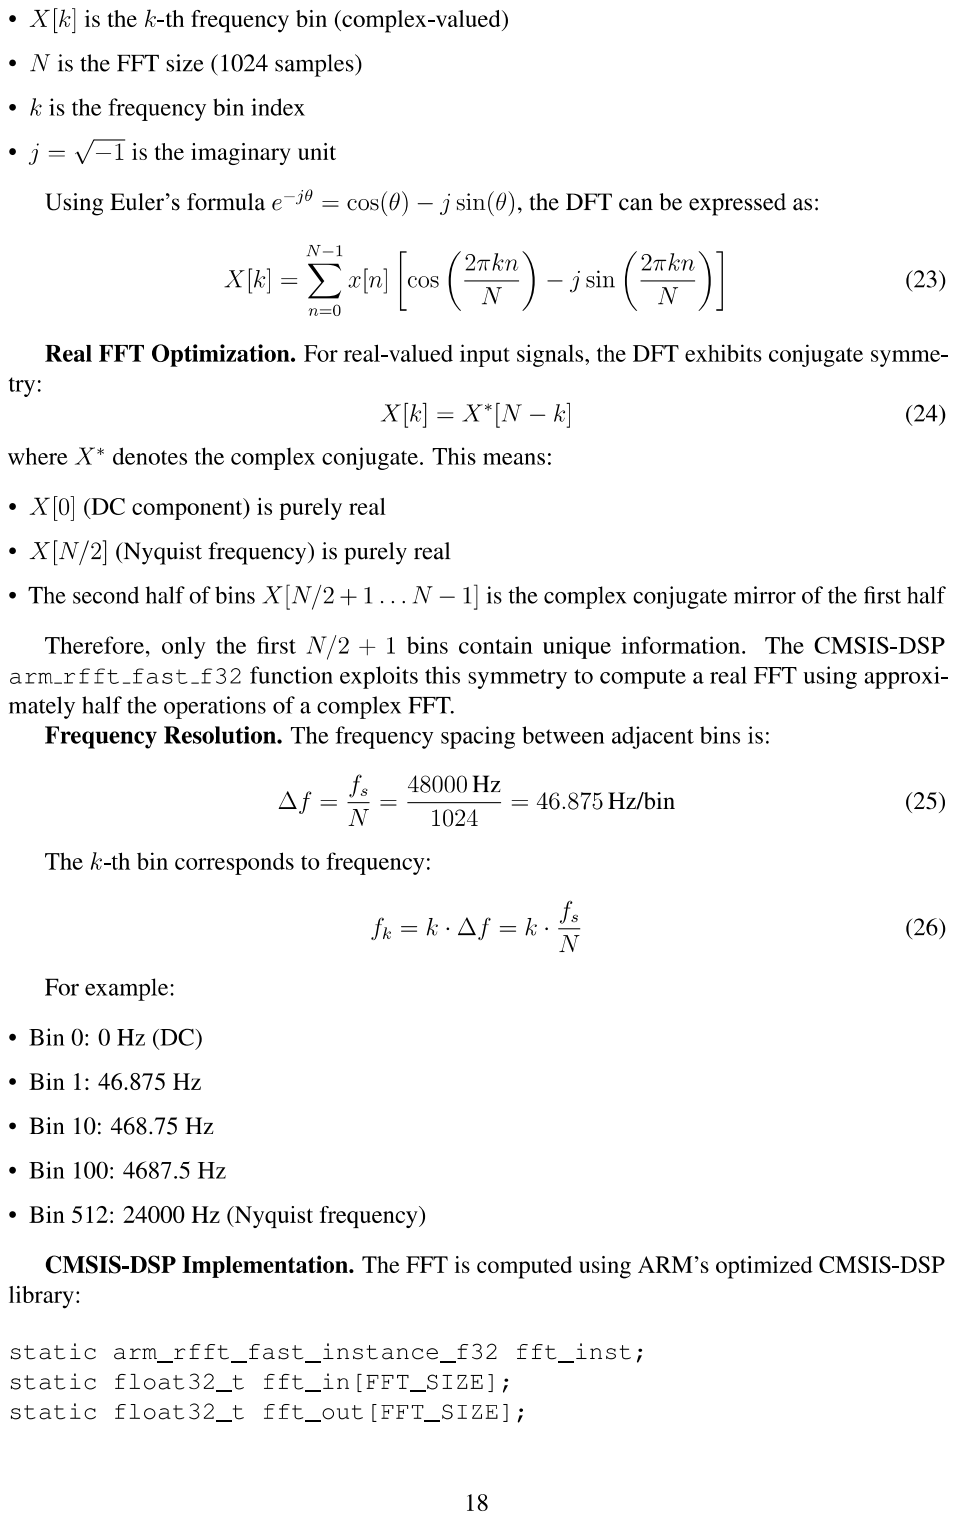
[picture p35: page 23]

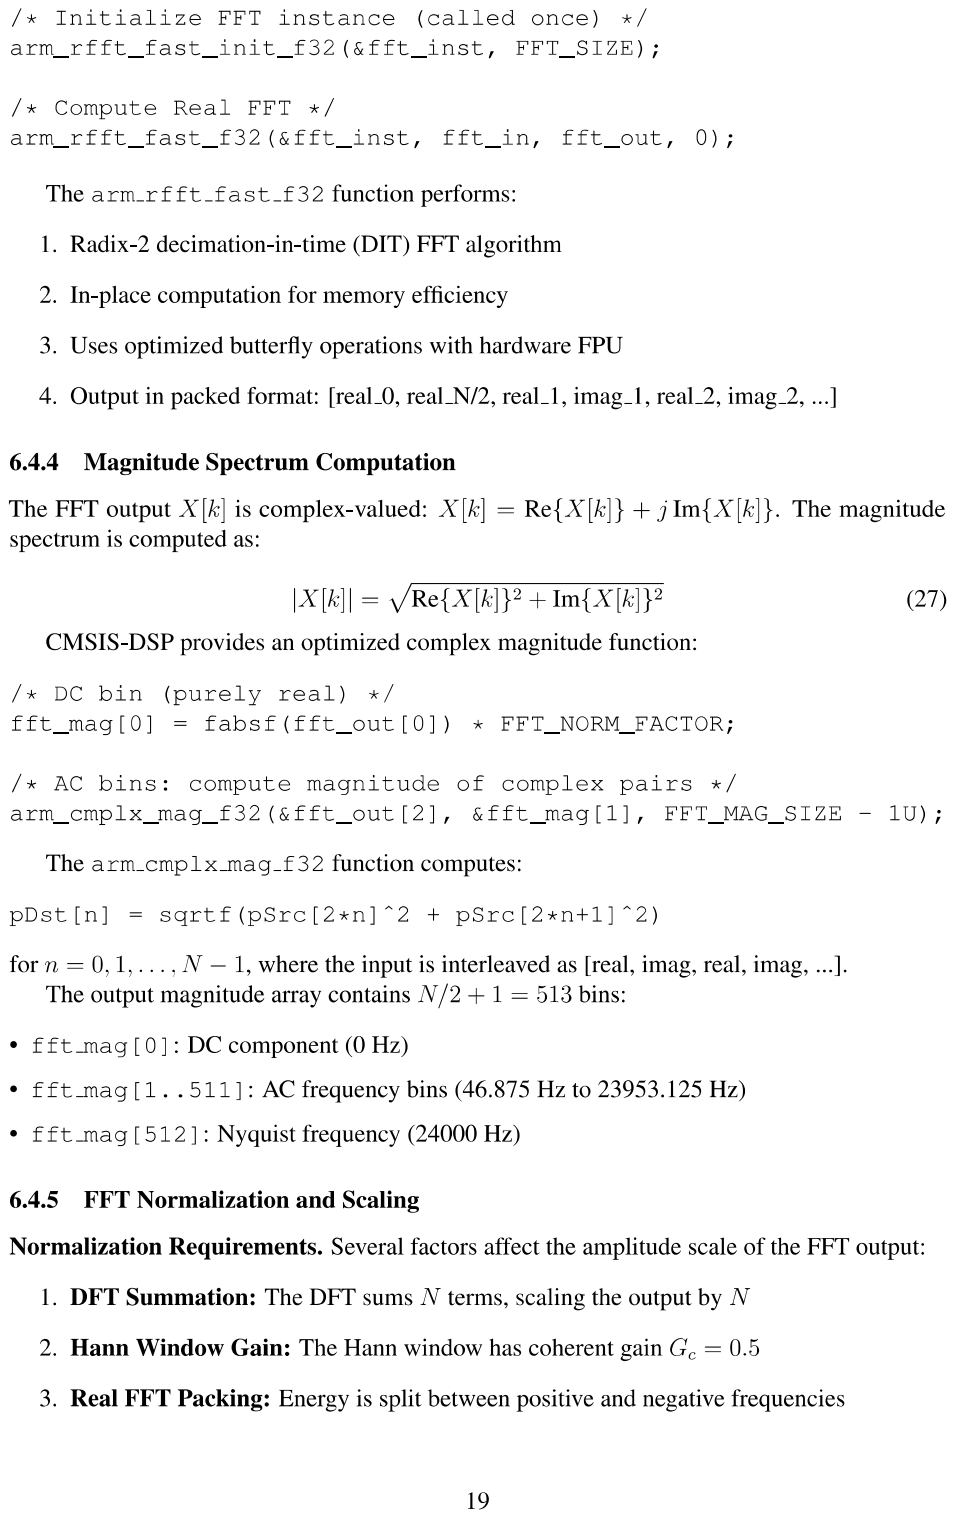
[picture p36: page 24]

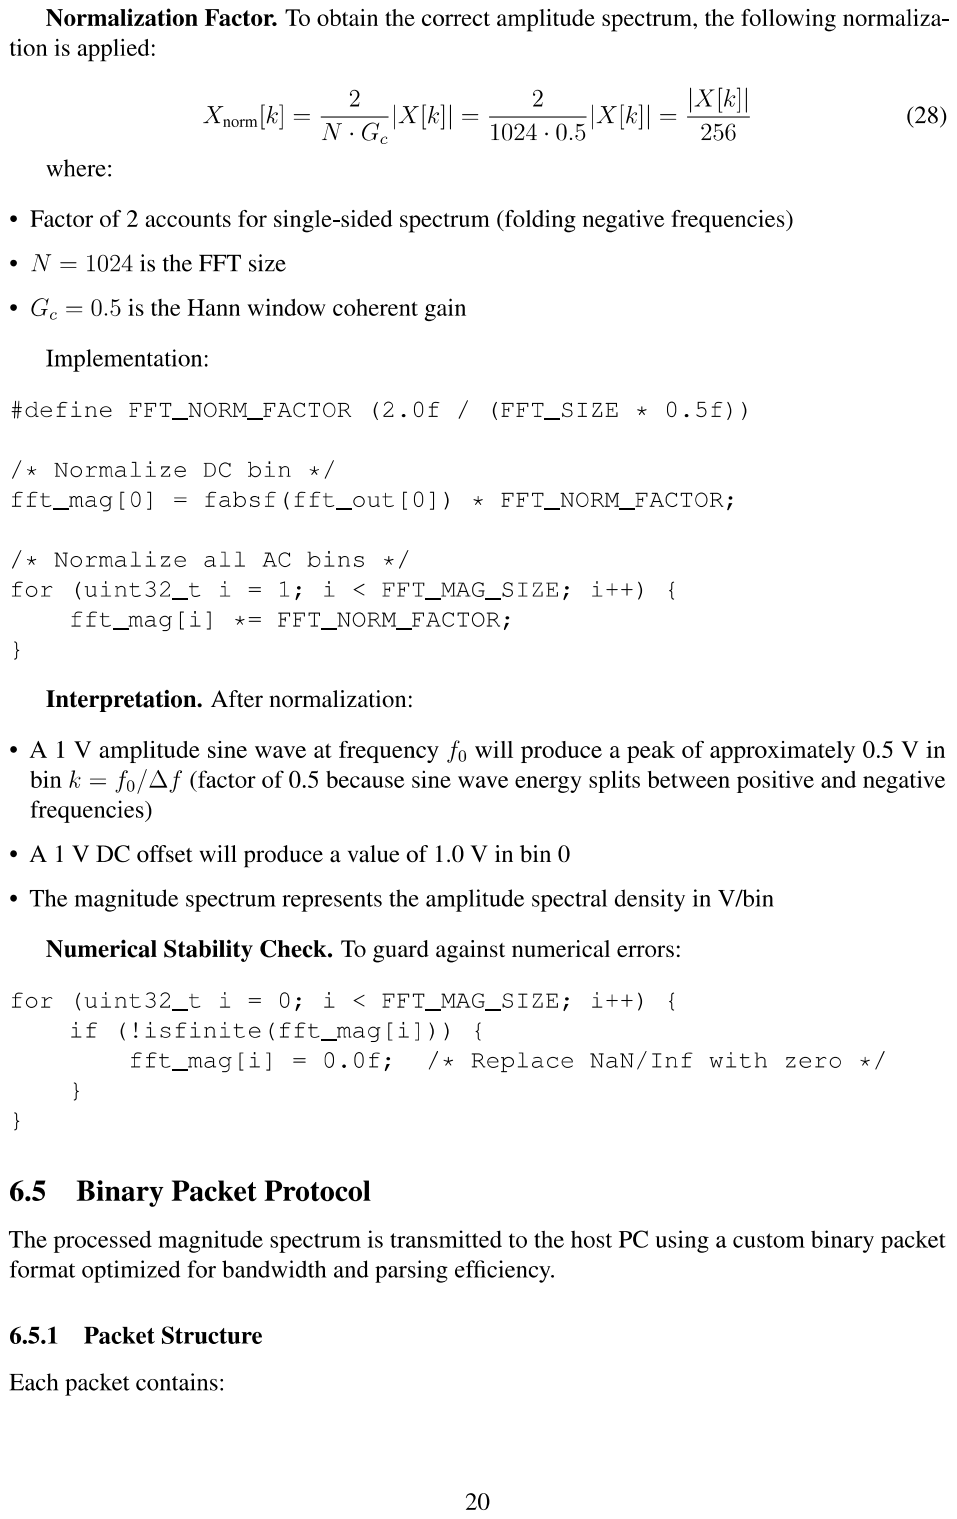
[picture p37: page 25]

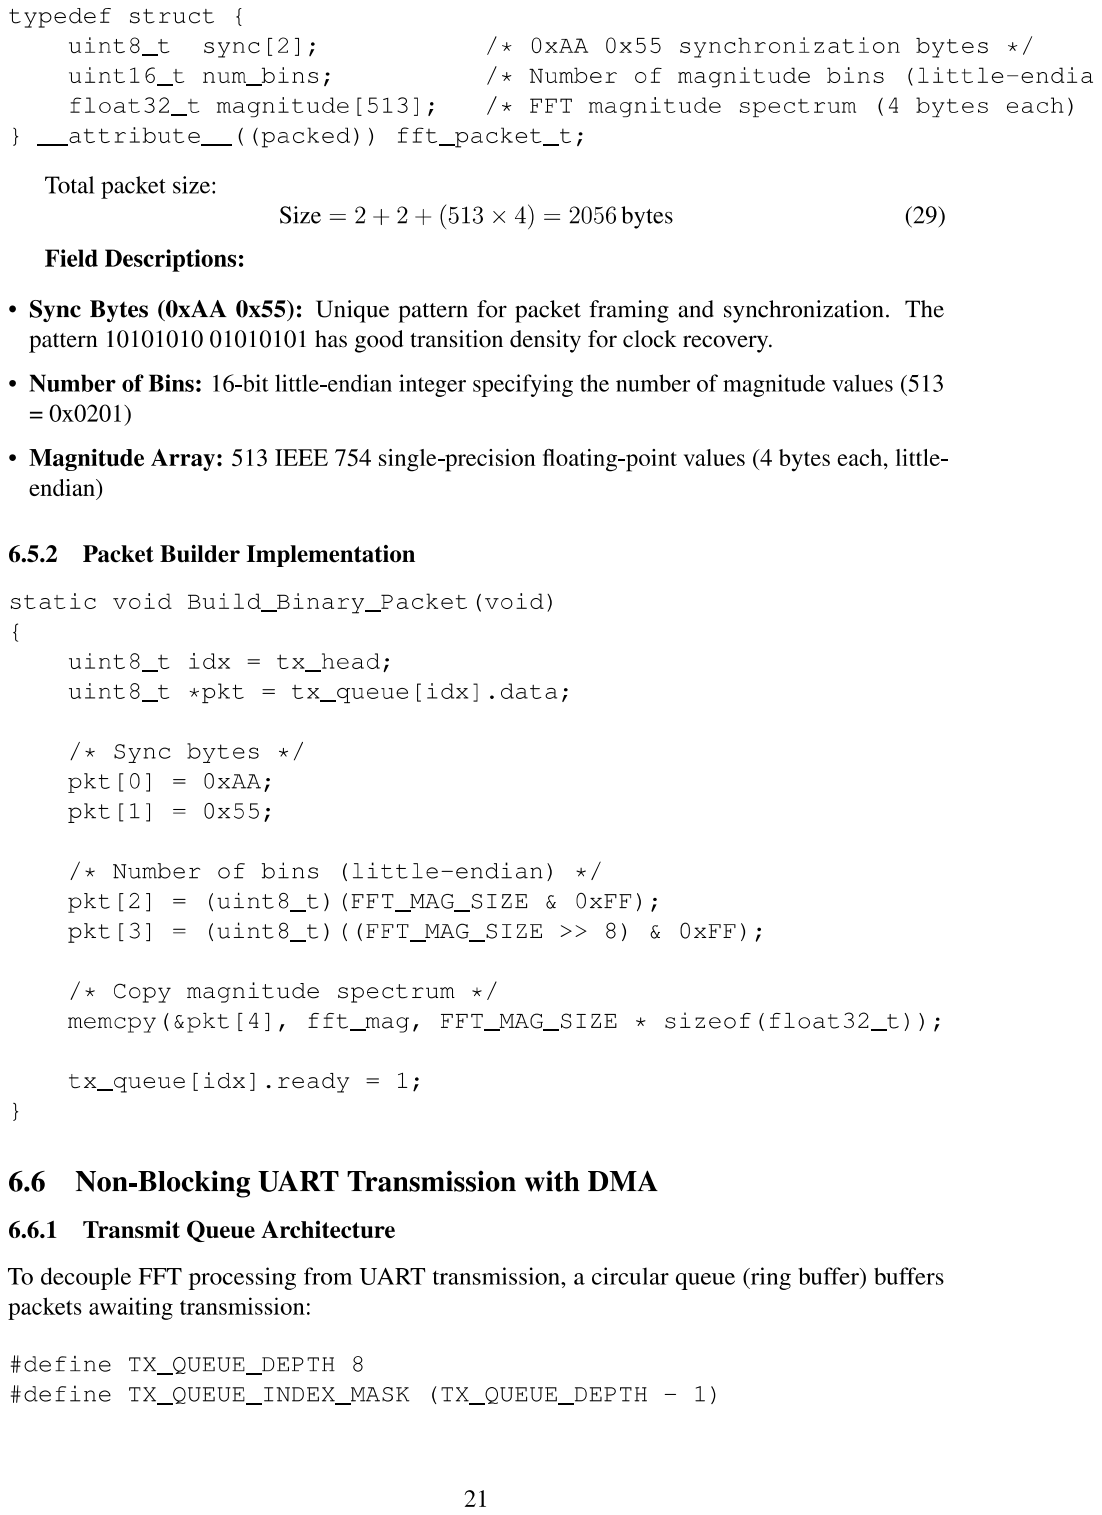
[picture p38: page 26]

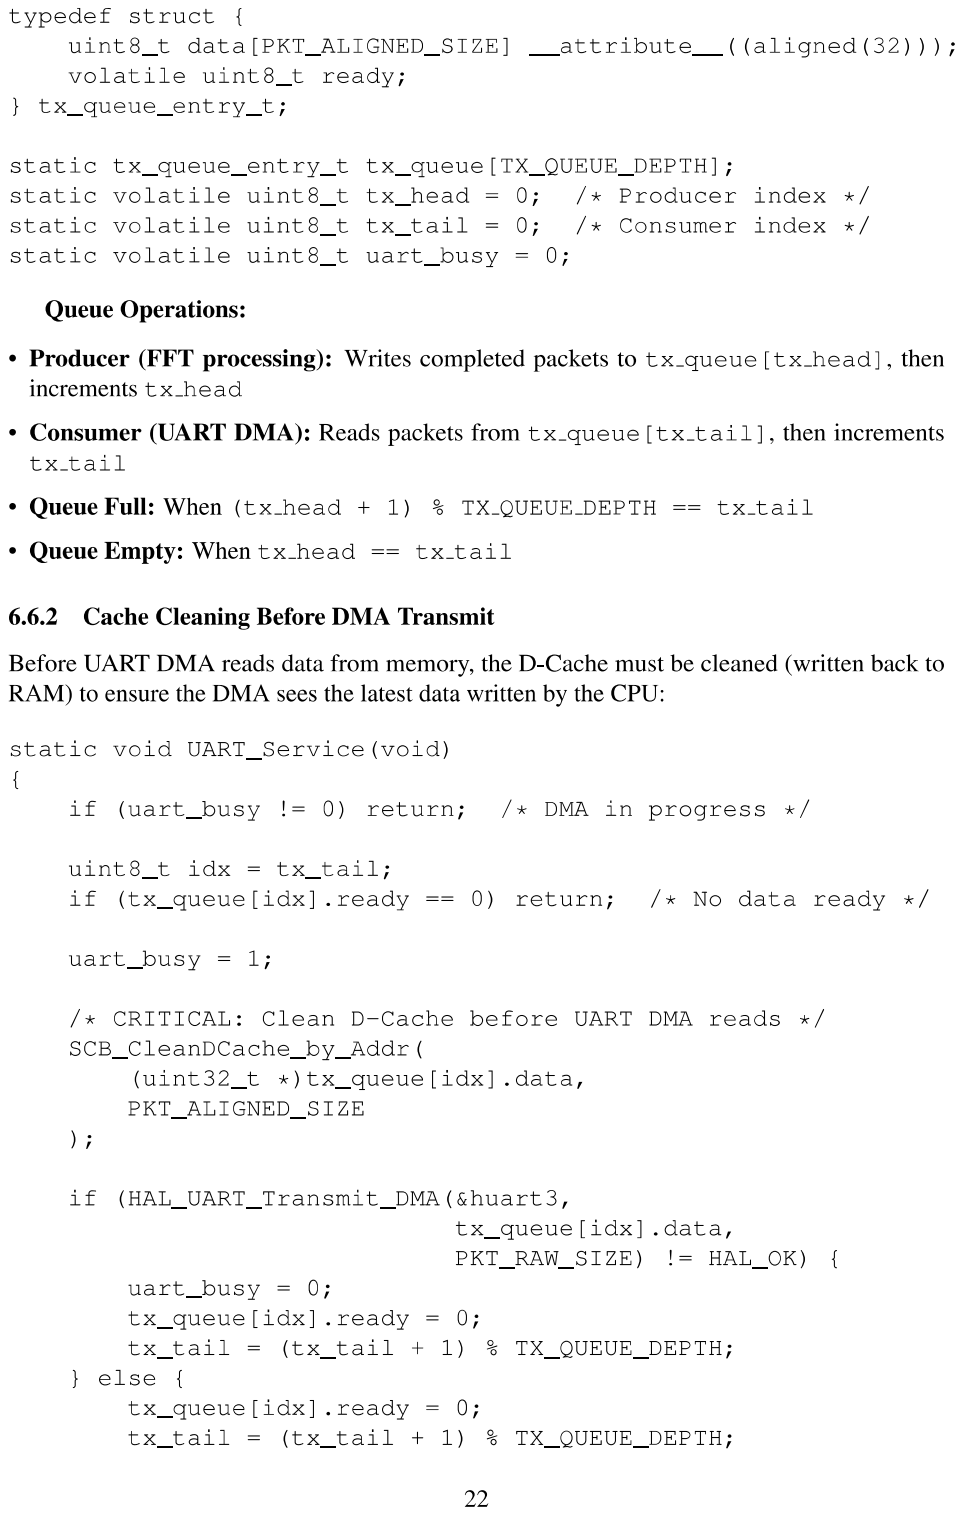
[picture p39: page 27]

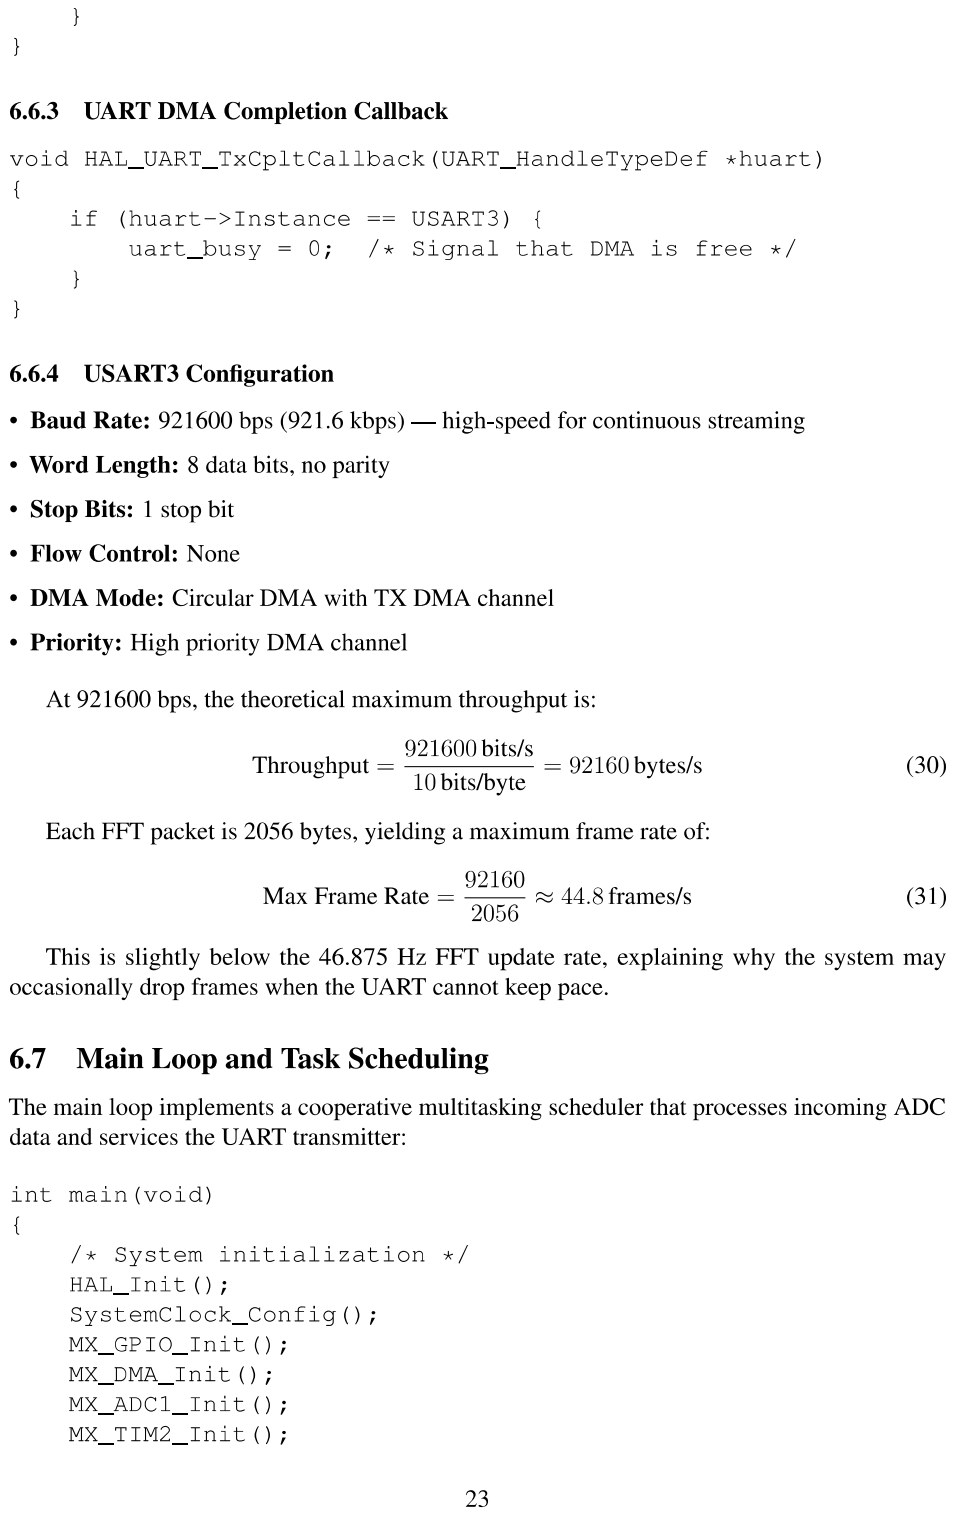
[picture p40: page 28]

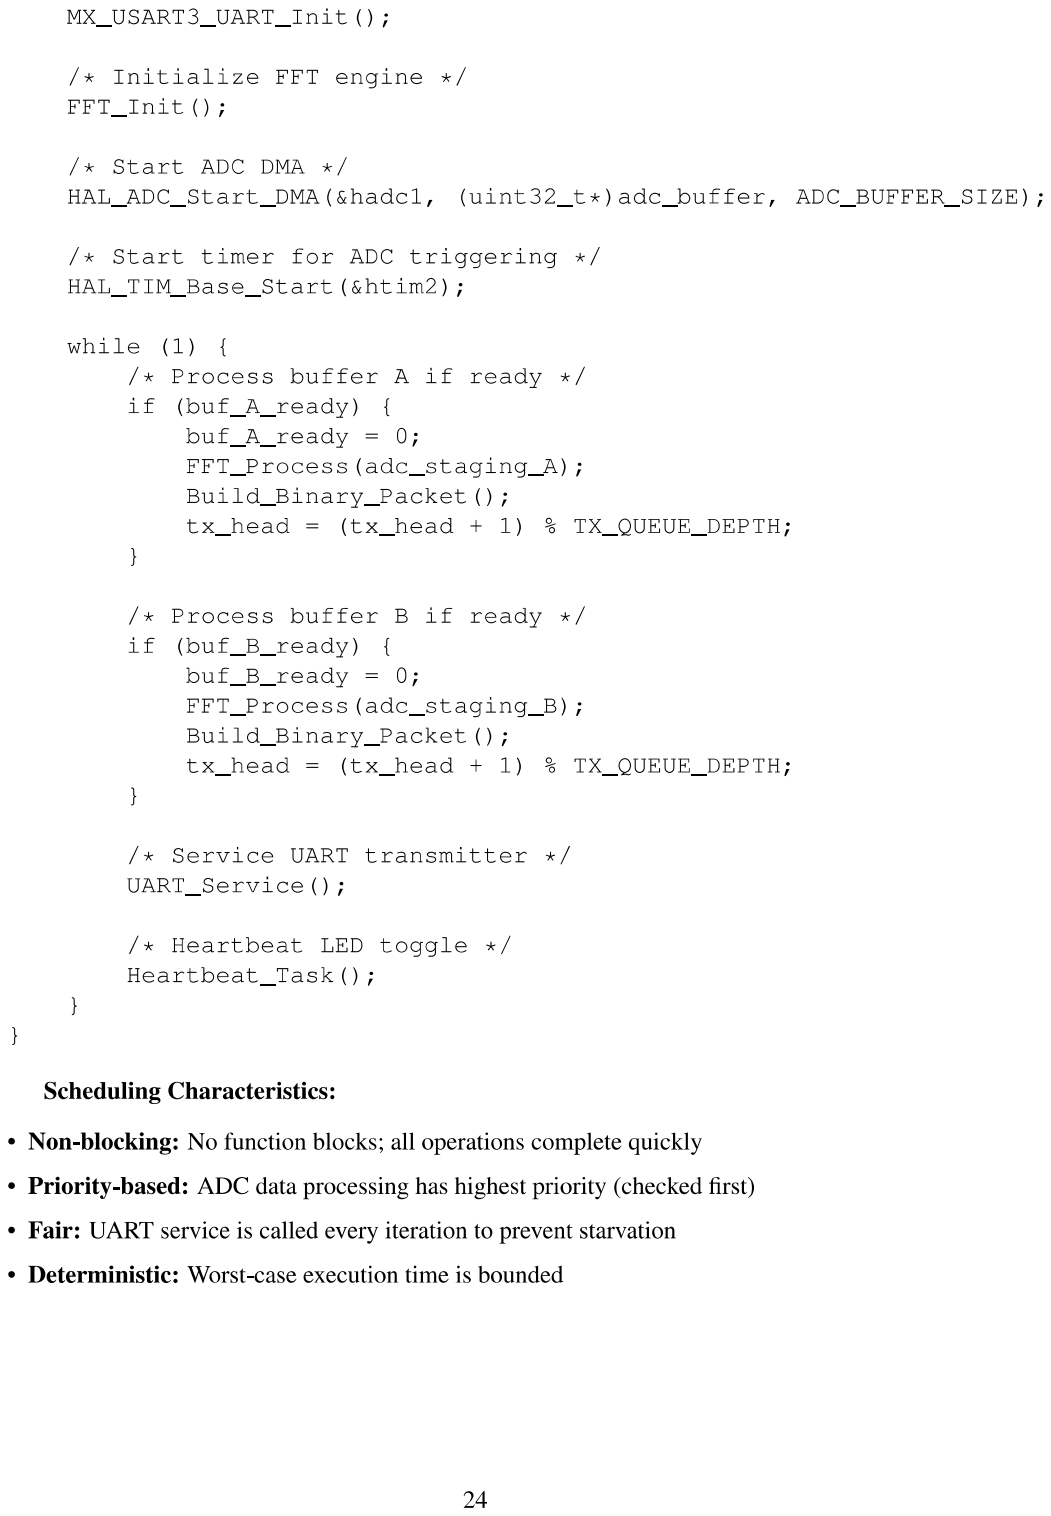
[picture p41: page 29]

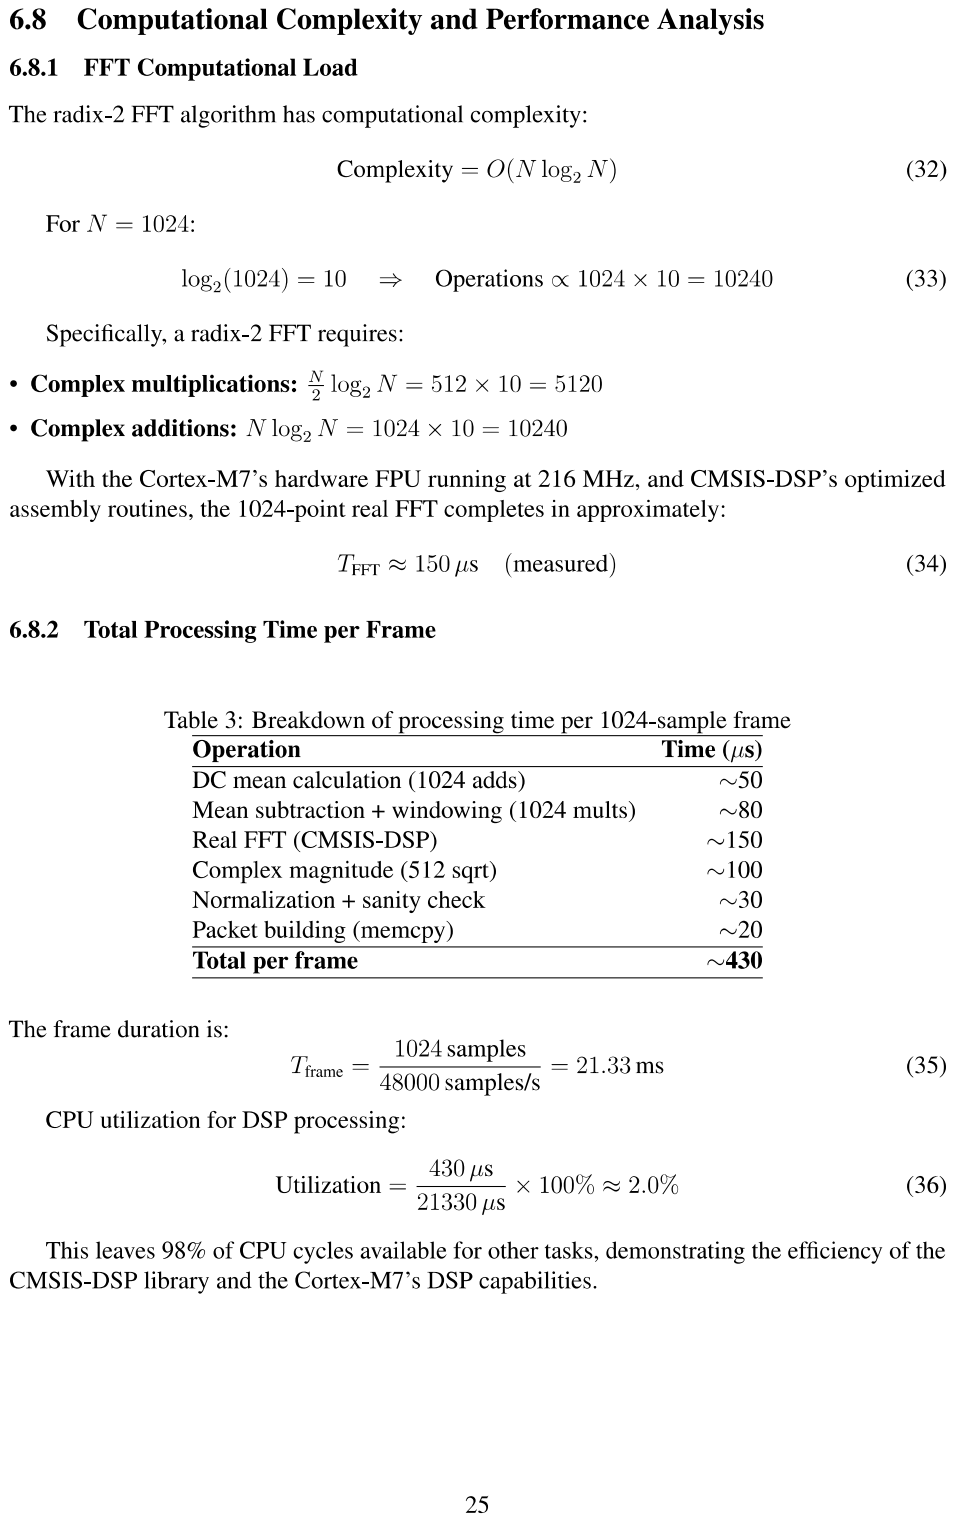
[picture p42: page 30]

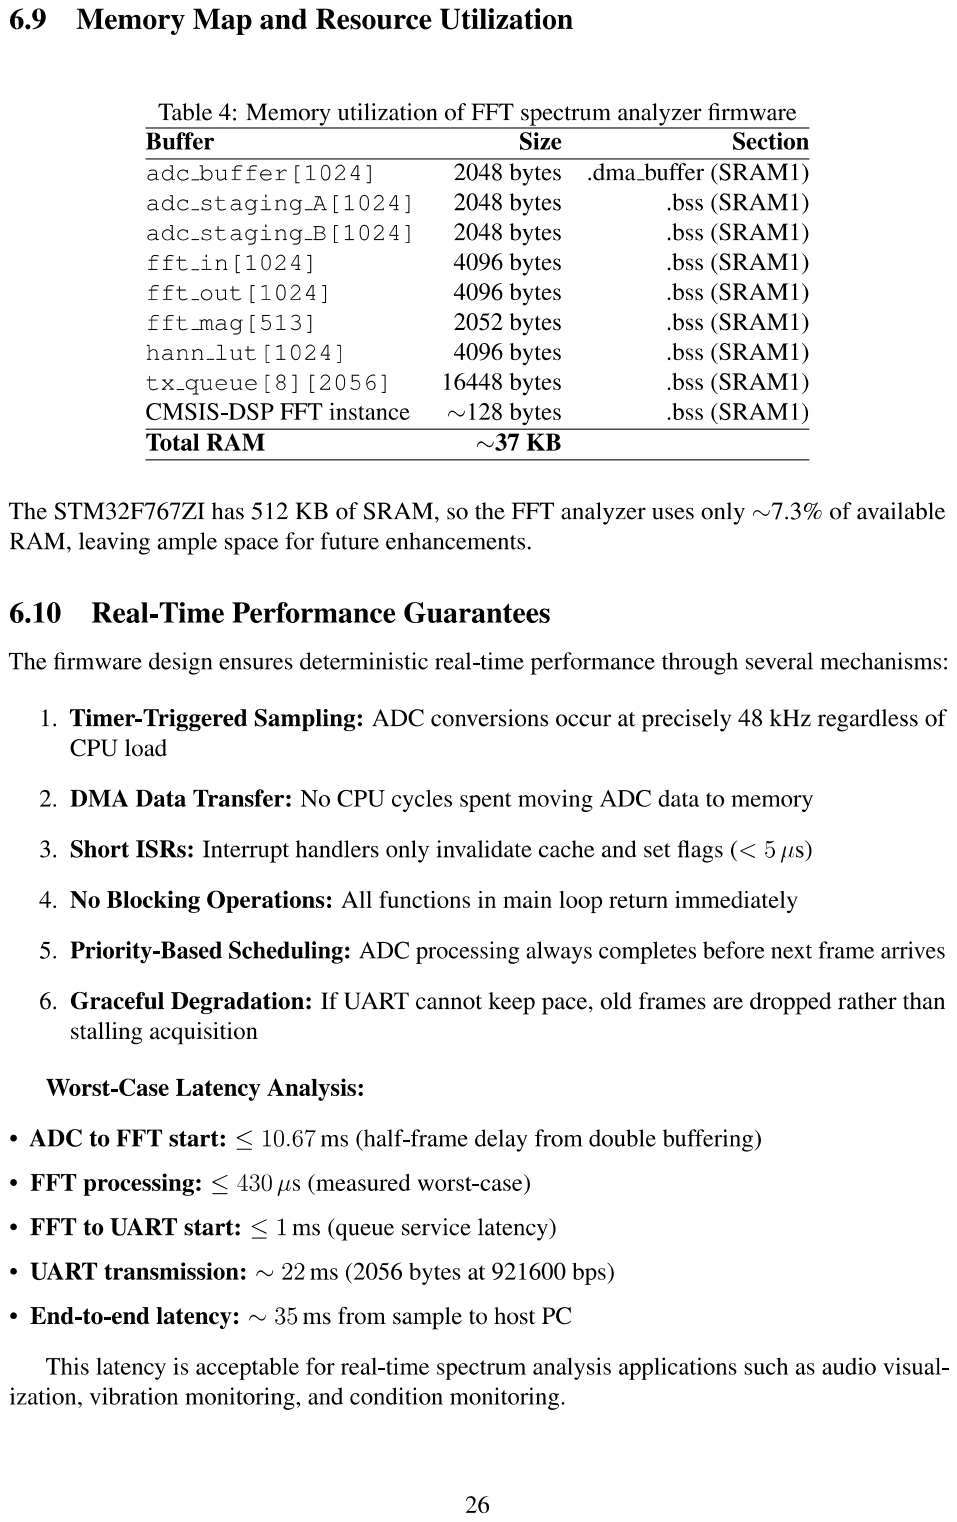
[picture p43: page 31]

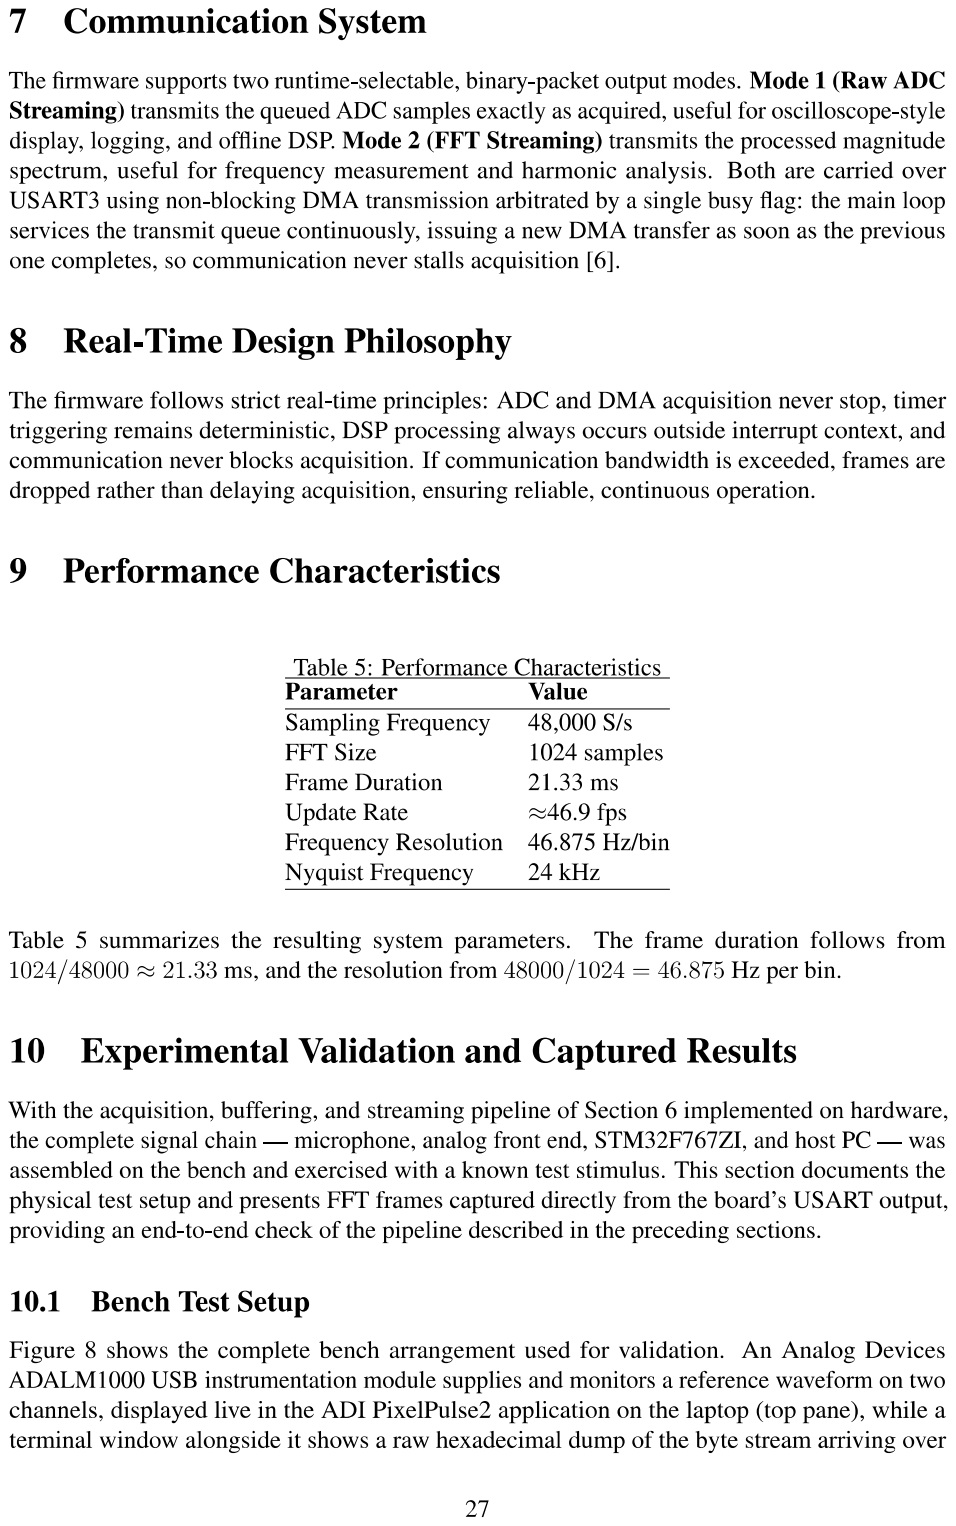
[picture p44: page 32]

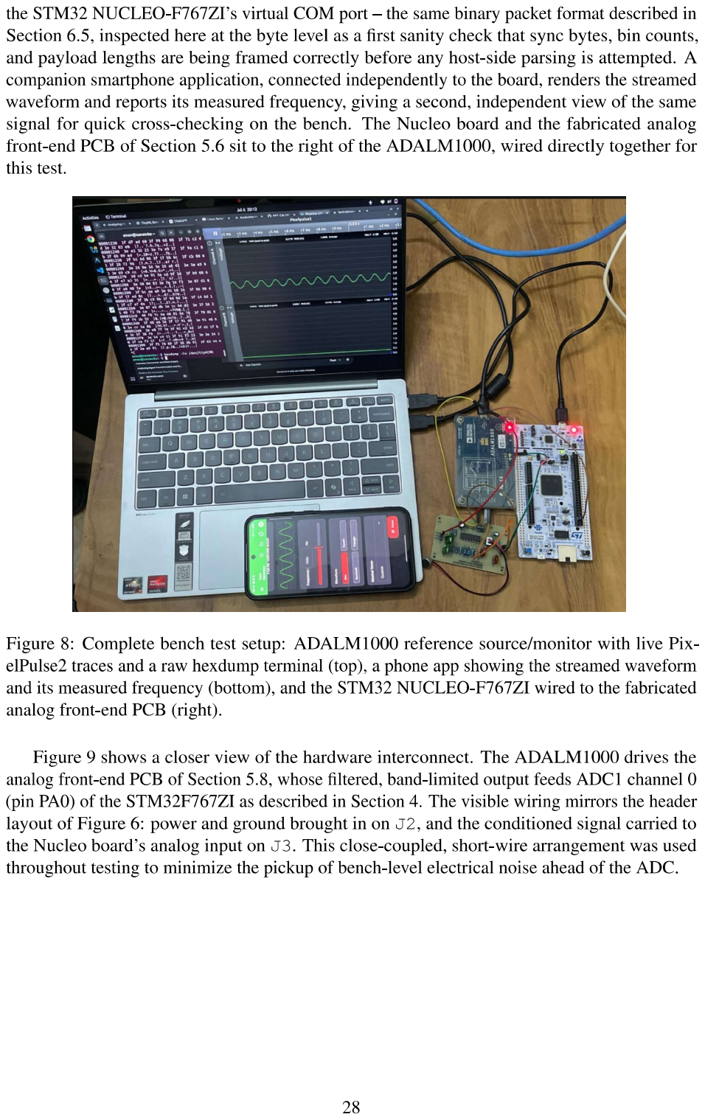
[picture p45: page 33]

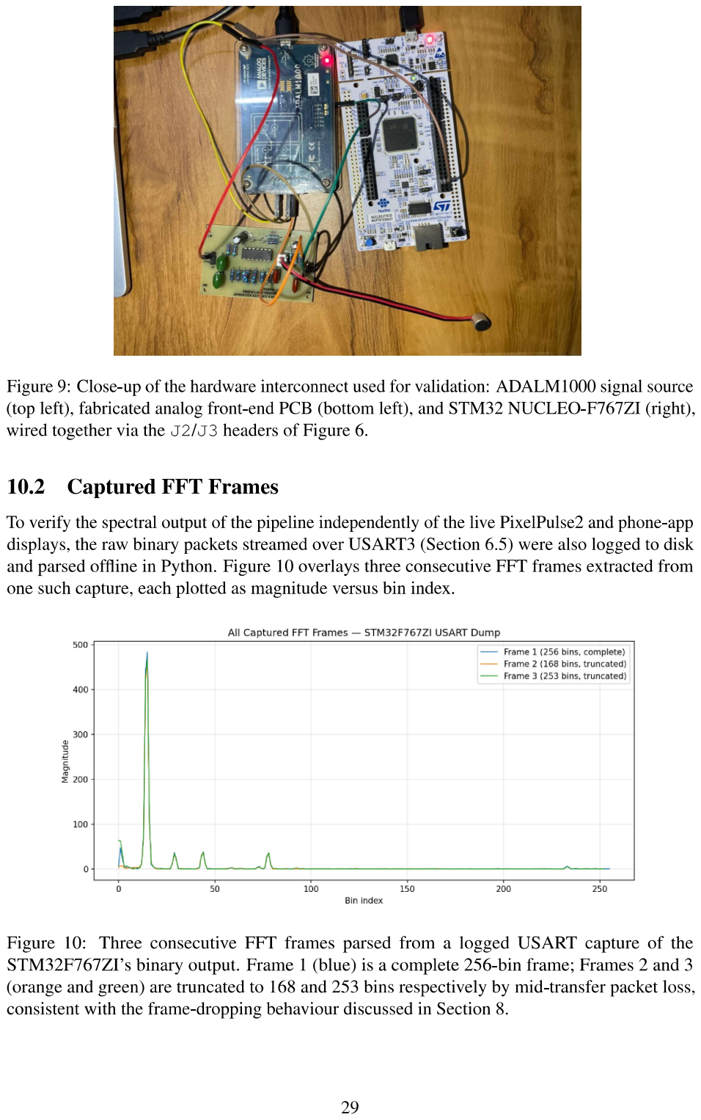
[picture p46: page 34]

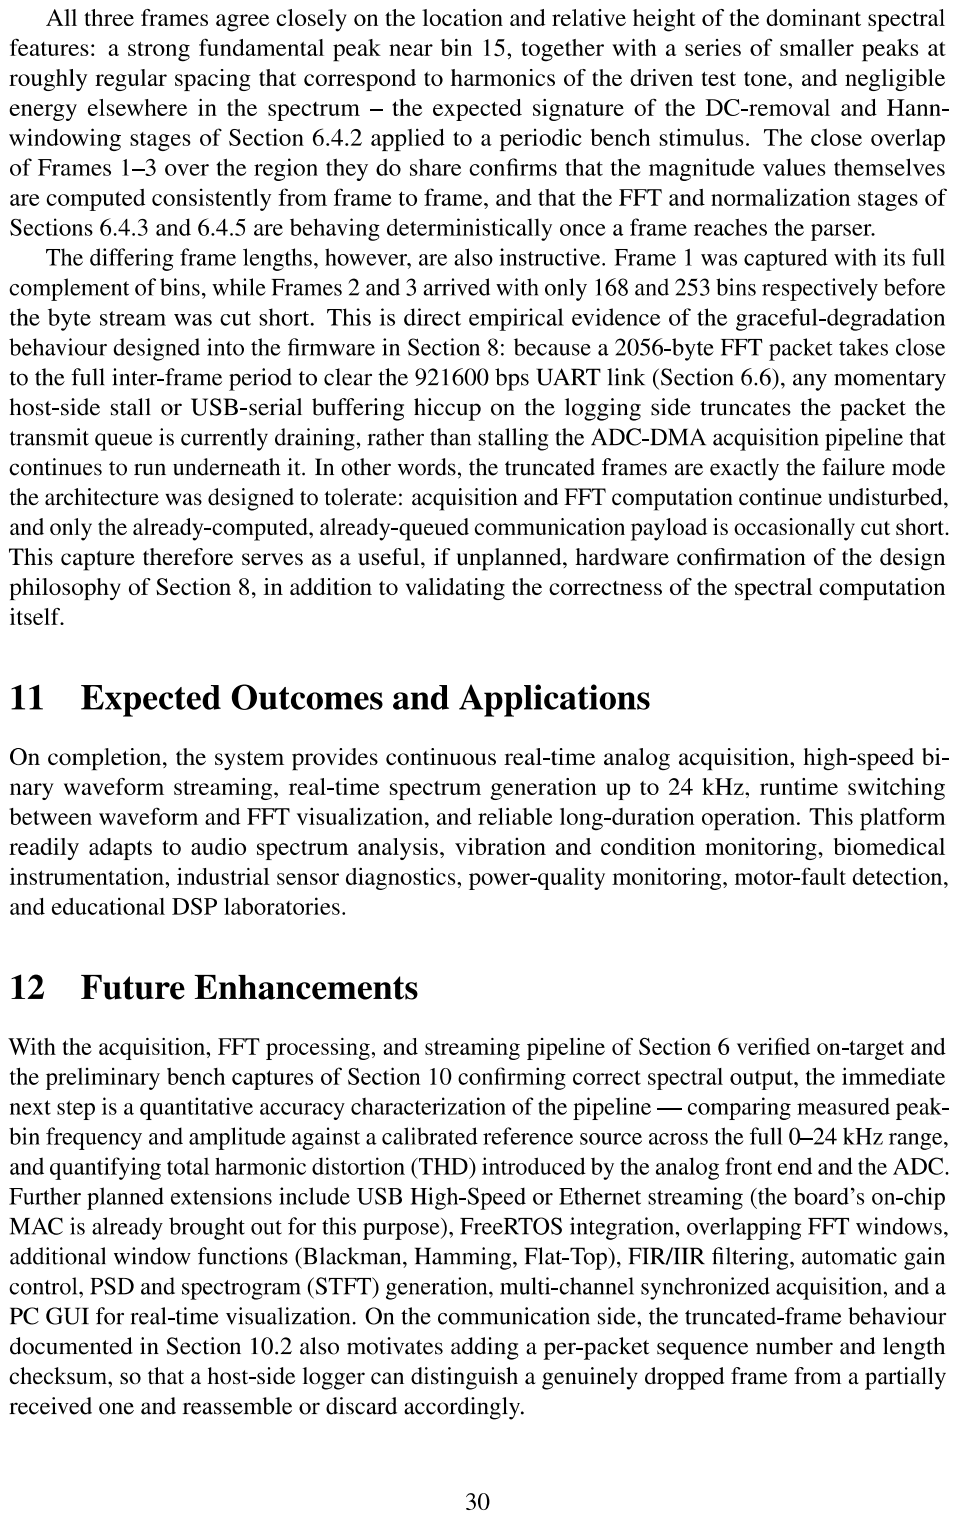
[picture p47: page 35]

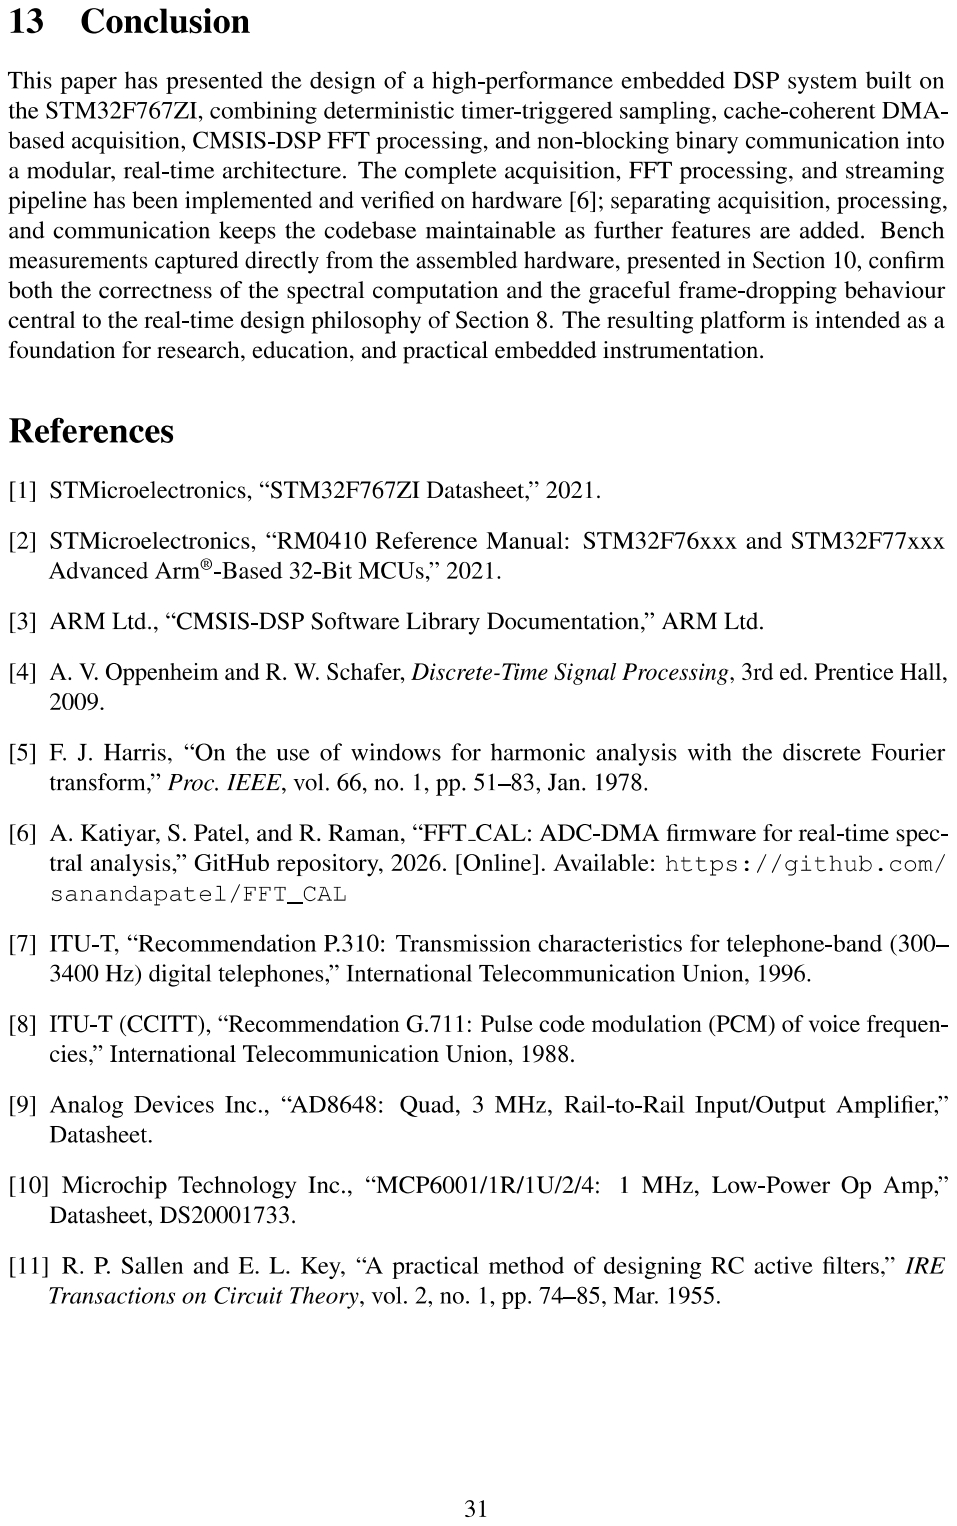
[picture p48: page 36]
