123Arp/Electronic_System_Project/ESP_SIGNAL_CONDITIONING.asc

C1: cap; 220µF
C2: cap; 100n
C3: cap; 100n
C4: cap; 10n
C5: cap; 10n
C6: cap; 10µF
R1: res; 1K
R2: res; 1K
R3: res; 47K
R4: res; 220K
R5: res; 3.3K
R6: res; 3.3K
R7: res; 4.7K
R8: res; 4.7K
R9: res; 220K
R10: res; 100K
R11: res; 47K
R12: res; 100K
R13: res; 47K
R14: res; 10K
R15: res; 10K
R16: res; 1K
R17: res; 47K
R18: res; 2.2K
R19: res; 2.2K
U1: AD8648
U2: AD8648
U4: AD8648
U6: AD8648
V1: voltage; 5V
V2: voltage; SINE(0 50m 3000); AC 1
V5: voltage; 3.3V
Named nets: 0, 5V, Vout, 3V3, ADD, Vcon
Low Pass Filter
High Pass Filter
Power Supply
Team
Sanand Patel (24f2100239)
Arpit Katiyar (24F1100064)
Rudra Raman (23f3000650)
Mic
BandPass 300Hz - 3400Hz
.tran 50ms
Microphone Amplifier circuit
.ac dec 10 50 50K
