123Arp/Electronic_System_Project/Core/Src/main.c

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

/* Includes ------------------------------------------------------------------*/
#include "main.h"
#include "arm_math.h"

/* USER CODE BEGIN Includes */
#include <math.h>
#include <string.h>
#include <stdio.h>
/* USER CODE END Includes */

/* USER CODE BEGIN TD */

/* ---- Spectrum Analyzer Configuration ---- */
#define FFT_SIZE 1024U
#define FFT_HALF (FFT_SIZE / 2U)
#define DMA_BUF_SIZE (FFT_SIZE * 2U)
#define PACKET_HEADER 0xA55AA55AU

typedef struct __attribute__((packed)) {
    uint32_t header;
    uint32_t frame_id;
    uint16_t fft_bins;
    uint16_t reserved;
    float magnitude[FFT_HALF];
} FFTPacket_t;

/* USER CODE END TD */


ADC_HandleTypeDef hadc1;
DMA_HandleTypeDef hdma_adc1;
DMA_HandleTypeDef hdma_usart2_tx;
TIM_HandleTypeDef htim6;
UART_HandleTypeDef huart2;

/* USER CODE BEGIN PV */

/* DMA Double Buffer */
static uint16_t adc_dma_buf[DMA_BUF_SIZE] __attribute__((aligned(4)));

/* FFT Processing Buffers */
static float32_t fft_input[FFT_SIZE];
static float32_t fft_output[FFT_SIZE * 2];
float32_t mag_buf[FFT_HALF];

/* Hann Window */
static float32_t hann_window[FFT_SIZE];

/* CMSIS-DSP FFT Instance */
static arm_rfft_fast_instance_f32 fft_instance;

/* Processing Flags */
static volatile uint8_t half_ready = 0;
static volatile uint8_t full_ready = 0;

/* UART TX DMA busy flag */
volatile uint8_t uart_tx_busy = 0;

/* Frame counter */
static uint32_t frame_id = 0;

/* Test pattern flag */
static uint8_t test_mode = 1;  /* Set to 0 for real ADC data */

/* USER CODE END PV */

void SystemClock_Config(void);
static void MX_GPIO_Init(void);
static void MX_DMA_Init(void);
static void MX_ADC1_Init(void);
static void MX_TIM6_Init(void);
static void MX_USART2_Init(void);
static void Generate_Hann_Window(void);
static void Process_FFT_Block(const uint16_t *samples);
static void Send_FFT_Packet(void);
static void Generate_Test_Signal(void);

/* USER CODE BEGIN 0 */

/* ============================================================================
 *  HANN WINDOW GENERATION
 * ==========================================================================*/
static void Generate_Hann_Window(void) {
    for (uint32_t n = 0; n < FFT_SIZE; n++) {
        hann_window[n] = 0.5f * (1.0f - cosf(2.0f * (float)M_PI * (float)n / (float)(FFT_SIZE - 1)));
    }
}

/* ============================================================================
 *  GENERATE TEST SIGNAL (for debugging without ADC)
 * ==========================================================================*/
static void Generate_Test_Signal(void) {
    static uint16_t phase = 0;
    static uint32_t sample_count = 0;

    /* Generate a sine wave at 10% of sampling rate */
    for (uint32_t i = 0; i < FFT_SIZE; i++) {
        float val = 2048.0f + 1024.0f * sinf(2.0f * (float)M_PI * 100.0f * (float)i / FFT_SIZE);
        adc_dma_buf[sample_count++] = (uint16_t)val;
        if (sample_count >= DMA_BUF_SIZE) {
            sample_count = 0;
            /* Trigger processing */
            if (half_ready == 0) {
                half_ready = 1;
            }
        }
    }
}

/* ============================================================================
 *  FFT PROCESSING
 * ==========================================================================*/
static void Process_FFT_Block(const uint16_t *samples) {
    float32_t sum = 0.0f;

    /* Convert to float and calculate mean */
    for (uint32_t i = 0; i < FFT_SIZE; i++) {
        fft_input[i] = (float32_t)samples[i];
        sum += fft_input[i];
    }

    /* DC removal */
    float32_t dc_mean = sum / (float32_t)FFT_SIZE;

    /* Apply Hann window */
    for (uint32_t i = 0; i < FFT_SIZE; i++) {
        fft_input[i] = (fft_input[i] - dc_mean) * hann_window[i];
    }

    /* FFT */
    arm_rfft_fast_f32(&fft_instance, fft_input, fft_output, 0);

    /* Magnitude calculation */
    mag_buf[0] = fabsf(fft_output[0]);
    arm_cmplx_mag_f32(&fft_output[2], &mag_buf[1], FFT_HALF - 1);
}

/* ============================================================================
 *  SEND FFT PACKET VIA UART DMA
 * ==========================================================================*/
static void Send_FFT_Packet(void) {
    static FFTPacket_t packet;

    /* Only send if UART is not busy */
    if (uart_tx_busy == 0) {
        /* Fill packet */
        packet.header = PACKET_HEADER;
        packet.frame_id = frame_id++;
        packet.fft_bins = FFT_HALF;
        packet.reserved = 0;

        /* Copy magnitude data */
        memcpy(packet.magnitude, mag_buf, sizeof(float) * FFT_HALF);

        /* Start UART DMA transmission */
        uart_tx_busy = 1;
        if (HAL_UART_Transmit_DMA(&huart2, (uint8_t*)&packet, sizeof(FFTPacket_t)) != HAL_OK) {
            uart_tx_busy = 0;  /* Reset on error */
        }
    }
}

/* USER CODE END 0 */

/**
  * @brief  The application entry point.
  * @retval int
  */
int main(void) {
    /* MCU Configuration--------------------------------------------------------*/
    HAL_Init();

    /* Configure the system clock */
    SystemClock_Config();

    /* Initialize all configured peripherals */
    MX_GPIO_Init();
    MX_DMA_Init();
    MX_ADC1_Init();
    MX_TIM6_Init();
    MX_USART2_Init();

    /* USER CODE BEGIN 2 */

    /* CMSIS-DSP: initialize FFT */
    arm_rfft_fast_init_f32(&fft_instance, FFT_SIZE);

    /* Pre-compute Hann window */
    Generate_Hann_Window();

    /* Send startup message */
    uint8_t startup_msg[] = "STM32 FFT UART READY\r\n";
    HAL_UART_Transmit(&huart2, startup_msg, sizeof(startup_msg) - 1, 1000);

    /* Start ADC DMA */
    HAL_ADC_Start_DMA(&hadc1, (uint32_t *)adc_dma_buf, DMA_BUF_SIZE);

    /* Start TIM6 */
    HAL_TIM_Base_Start(&htim6);

    /* USER CODE END 2 */
    uint8_t test_msg[] = "UART TEST\r\n";

    /* Infinite loop */
    while (1) {

        HAL_UART_Transmit(&huart2, test_msg, sizeof(test_msg)-1, 1000);
        HAL_Delay(1000);
        /* USER CODE BEGIN WHILE */

        /* Process first half */
        if (half_ready) {
            half_ready = 0;
            Process_FFT_Block(&adc_dma_buf[0]);
            Send_FFT_Packet();
        }

        /* Process second half */
        if (full_ready) {
            full_ready = 0;
            Process_FFT_Block(&adc_dma_buf[FFT_SIZE]);
            Send_FFT_Packet();
        }

        /* Generate test signal if in test mode */
        if (test_mode) {
            Generate_Test_Signal();
            HAL_Delay(10);
        }






        /* USER CODE END WHILE */
    }
}

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
/* USER CODE BEGIN 4 */

/* ============================================================================
 *  DMA CALLBACKS
 * ==========================================================================*/
void HAL_ADC_ConvHalfCpltCallback(ADC_HandleTypeDef *hadc) {
    if (hadc->Instance == ADC1) {
        half_ready = 1;
    }
}

void HAL_ADC_ConvCpltCallback(ADC_HandleTypeDef *hadc) {
    if (hadc->Instance == ADC1) {
        full_ready = 1;
    }
}

/* ============================================================================
 *  UART CALLBACKS
 * ==========================================================================*/
void HAL_UART_TxCpltCallback(UART_HandleTypeDef *huart) {
    if (huart->Instance == USART2) {
        uart_tx_busy = 0;
    }
}

void HAL_UART_ErrorCallback(UART_HandleTypeDef *huart) {
    if (huart->Instance == USART2) {
        uart_tx_busy = 0;
        HAL_UART_Abort(&huart2);
    }
}

/* USER CODE END 4 */
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
