123Arp/Electronic_System_Project/(notices)

Notices in the files:
README.md:
License: Apache 2.0
